fulmsch/ZI28/system/os/src/drivers/unio.org

#+TITLE: UNI/O EEPROM driver
#+PROPERTY: header-args :tangle yes

The start of a driver for the ROM on the expansion modules. Might not share an
interface with the other drivers.

#+BEGIN_SRC asm
SECTION rom_code
#code ROM
unio_fileDriver:
    DEFW unio_read
    DEFW 0 ;write

#define UNIO_STARTHEADER 0x55
#define UNIO_READ        0x03
#define UNIO_CRRD        0x06
#define UNIO_WRITE       0x6c
#define UNIO_WREN        0x96
#define UNIO_WRDI        0x91
#define UNIO_RDSR        0x05
#define UNIO_WRSR        0x6e
#define UNIO_ERAL        0x6d
#define UNIO_SETAL       0x67

unio_read:
;;
;; Input:
;; : ix - file entry addr
;; : (de) - buffer
;; : bc - count
;;
;; Output:
;; : de - count
;; : a - errno
#+END_SRC
