fulmsch/ZI28/system/os/src/math.org

#+TITLE: Math library
#+PROPERTY: header-args :tangle yes

Advanced math routines

Based on: <http://www.ticalc.org/pub/83/asm/source/routines/math32.inc>

* 32-bit registers
Define three variables to be used as temporary registers for 32-bit operations.

#+BEGIN_SRC asm
#data RAM
regA: defs 4
regB: defs 4
regC: defs 4

#code ROM
#+END_SRC

* Addition

#+BEGIN_SRC asm
add32:
;; Add two 32-bit numbers
;;
;; Input:
;; : (hl), (de) - 32-bit numbers
;;
;; Output:
;; : (hl) = (hl) + (de)
;;
;; Destroyed:
;; : none

    ;clear the carry flag
    or a

adc32:
;; Add two 32-bit numbers and the carry bit
;;
;; Input:
;; : (hl), (de) - 32-bit numbers
;;
;; Output:
;; : (hl) = (hl) + (de) + cf
;;
;; Destroyed:
;; : none

#local
    push af
    push bc
    push de
    push hl

    ld b, 4
loop:
    ld a, (de)
    adc a, (hl)
    ld (hl), a
    inc hl
    inc de
    djnz loop

    pop hl
    pop de
    pop bc
    pop af

    ret
#endlocal
#+END_SRC

* Subtraction

#+BEGIN_SRC asm
sub32:
;; Subtract two 32-bit numbers
;;
;; Input:
;; : (hl), (de) - 32-bit numbers
;;
;; Output:
;; : (de) = (de) - (hl)
;;
;; Destroyed:
;; : none

    ;clear the carry flag
    or a

sbc32:
;; Subtract two 32-bit numbers and the carry bit
;;
;; Input:
;; : (hl), (de) - 32-bit numbers
;;
;; Output:
;; : (de) = (de) - (hl) - cf
;;
;; Destroyed:
;; : none

#local
    push af
    push bc
    push de
    push hl

    ld b, 4
loop:
    ld a, (de)
    sbc a, (hl)
    ld (de), a
    inc de
    inc hl
    djnz loop

    pop hl
    pop de
    pop bc
    pop af

    ret
#endlocal
#+END_SRC

* Inc32

#+BEGIN_SRC asm
inc32:
;; Increment a 32-bit number by 1
;;
;; Input:
;; : (hl) - 32-bit number
;;
;; Output:
;; : (hl) = (hl) + 1
;;
;; Destroyed:
;; : none

#local
    push hl

    inc (hl)
    jr nz, exit
    inc hl
    
    inc (hl)
    jr nz, exit
    inc hl

    inc (hl)
    jr nz, exit
    inc hl

    inc (hl)

exit:
    pop hl
    ret
#endlocal
#+END_SRC

* Dec32

#+BEGIN_SRC asm
dec32:
;; Decrement a 32-bit number by 1
;;
;; Input:
;; : (hl) - 32-bit number
;;
;; Output:
;; : (hl) = (hl) - 1
;;
;; Destroyed:
;; : none

#local
    push hl

    dec (hl)
    jp p, exit
    inc hl

    dec (hl)
    jp p, exit
    inc hl

    dec (hl)
    jp p, exit
    inc hl

    dec (hl)

exit:
    pop hl
    ret
#endlocal
#+END_SRC

* Shifts
There are currently three shift instructions for each direction:
 - Shift one bit (multiplication by 2)
 - Shift 8 bits (multiplication by 256)
 - Shift 9 bits (multiplication by 512)

** Left shift

#+BEGIN_SRC asm
lshiftbyte32:
;; Shift a 32-bit number left by 1 byte
;;
;; Input:
;; : (hl) - 32-bit number
;;
;; Output:
;; : (hl) = (hl) << 8
;;
;; Destroyed:
;; : none

    push af
    push hl

    inc hl
    inc hl

    ld a, (hl)
    inc hl
    ld (hl), a
    dec hl
    dec hl

    ld a, (hl)
    inc hl
    ld (hl), a
    dec hl
    dec hl

    ld a, (hl)
    inc hl
    ld (hl), a
    dec hl
    ld (hl), 0

    pop hl
    pop af
    ret

lshift9_32:
;; Shift a 32-bit number left by 9 bits
;;
;; Input:
;; : (hl) - 32-bit number
;;
;; Output:
;; : (hl) = (hl) << 9
;;
;; Destroyed:
;; : none

    call lshiftbyte32

lshift32:
;; Shift a 32-bit number left by 1 bit
;;
;; Input:
;; : (hl) - 32-bit number
;;
;; Output:
;; : (hl) = (hl) << 1
;; : carry flag
;;
;; Destroyed:
;; : none

    push hl

    or a
    rl (hl)
    inc hl
    rl (hl)
    inc hl
    rl (hl)
    inc hl
    rl (hl)

    pop hl
    ret
#+END_SRC

** Right shift

#+BEGIN_SRC asm
rshiftbyte32:
;; Shift a 32-bit number right by 1 byte
;;
;; Input:
;; : (hl) - 32-bit number
;;
;; Output:
;; : (hl) = (hl) >> 8
;;
;; Destroyed:
;; : none

    push af
    push hl

    inc hl
    ld a, (hl)
    dec hl
    ld (hl), a
    inc hl

    inc hl
    ld a, (hl)
    dec hl
    ld (hl), a
    inc hl

    inc hl
    ld a, (hl)
    dec hl
    ld (hl), a
    inc hl

    ld (hl), 0

    pop hl
    pop af
    ret

rshift9_32:
;; Shift a 32-bit number right by 9 bits
;;
;; Input:
;; : (hl) - 32-bit number
;;
;; Output:
;; : (hl) = (hl) >> 9
;;
;; Destroyed:
;; : none

    call rshiftbyte32

rshift32:
;; Shift a 32-bit number right by 1 bit
;;
;; Input:
;; : (hl) - 32-bit number
;;
;; Output:
;; : (hl) = (hl) >> 1
;; : carry flag
;;
;; Destroyed:
;; : none

    or a
    inc hl
    inc hl
    inc hl

    rr (hl)
    dec hl
    rr (hl)
    dec hl
    rr (hl)
    dec hl
    rr (hl)
    ret
#+END_SRC

* Load

#+BEGIN_SRC asm
ld8:
;; Load an 8-bit number into a 32-bit pointer
;;
;; Input:
;; : a - 8-bit number
;; : hl - 32-bit pointer
;;
;; Output:
;; : (hl) = a
;;
;; Destroyed:
;; : none

    ;clear (hl)
    call clear32
    ld (hl), a
    ret

ld16:
;; Load a 16-bit number into a 32-bit pointer
;;
;; Input:
;; : de - 16-bit number
;; : hl - 32-bit pointer
;;
;; Output:
;; : (hl) = de
;;
;; Destroyed:
;; : none

    push hl

    ld (hl), e
    inc hl
    ld (hl), d
    inc hl
    ld (hl), 0
    inc hl
    ld (hl), 0

    pop hl
    ret

ld32:
;; Copy a 32-bit number from (hl) to (de)
;;
;; Input:
;; : (hl) - 32-bit number
;; : de - 32-bit pointer
;;
;; Destroyed:
;; : none

    push bc
    push de
    push hl

    ld bc, 4
    ldir

    pop hl
    pop de
    pop bc

    ret
#+END_SRC

* Compare

#+BEGIN_SRC asm
cp32:
;; Compares two 32-bit numbers
;;
;; Input:
;; : (hl), (de) - 32-bit numbers
;;
;; Output:
;; : c  - (hl) >  (de)
;; : nc - (hl) <= (de)
;; : z  - (hl) == (de)
;; : nz - (hl) != (de)
;;
;; Destroyed:
;; : a, b, de, hl

#local
;move the pointers to the msb
    ld b, 3
startLoop:
    inc hl
    inc de
    djnz startLoop

    ld b, 4
loop:
    ld a, (de)
    cp (hl)
    ret nz
    dec hl
    dec de
    djnz loop
    ret
#endlocal
#+END_SRC

* Clear

#+BEGIN_SRC asm
clear32:
;; Sets a 32-bit number to 0
;;
;; Input:
;; : (hl) - 32-bit number
;;
;; Output:
;; : (hl) = 0
;;
;; Destroyed:
;; : none

#local
    push hl
    push bc
    ld b, 4
loop:
    ld (hl), 0
    inc hl
    djnz loop

    pop bc
    pop hl
    ret
#endlocal
#+END_SRC
