fulmsch/ZI28/system/os/src/block.org

#+TITLE: Block device interface
#+PROPERTY: header-args :tangle yes

#+BEGIN_SRC asm

#data RAM
block_buffer:        defs 512
block_curBlock:      defs   4
block_endBlock:      defs   4
block_remCount:      defs   2
block_totalCount:    defs   2
block_relOffs:       defs   2
block_readCallback:  defs   2
block_writeCallback: defs   2
block_memPtr:        defs   2

#code ROM
;TODO give this a better name
block_calcCopyPointers:
;; Calculate the amount of bytes to be copied in a partial block operation
;;
;; Output:
;; bc - count
;; de - memory pointer
;; hl - buffer pointer

#local
    ld hl, 512
    ld de, (block_relOffs)
    or a
    sbc hl, de
    push hl ;bytes to end of block
    ;check if block_remCount < hl
    ld bc, (block_remCount)
    sbc hl, bc
    pop hl
    jr nc, remCount ;only read remCount bytes
    ld b, h
    ld c, l

remCount:
    ld hl, block_buffer
    add hl, de ;buffer + reloffs

    ld de, (block_memPtr)

    ret
#endlocal

block_nextBlock:
;; Advance to next block
;;
;; Input:
;; : bc - count

    ld hl, (block_totalCount)
    add hl, bc
    ld (block_totalCount), hl

    ld hl, (block_memPtr)
    add hl, bc
    ld (block_memPtr), hl

    ld hl, (block_remCount)
    or a
    sbc hl, bc
    ld (block_remCount), hl

    ld hl, block_curBlock
    jp inc32

#+END_SRC

* Init
#+BEGIN_SRC asm
#code ROM

block_init:
;; Calculate the current and final block, and the relative offset
;;
;; Output:
;; : carry - start with a partial block
;; : no carry - start with a full block

#local
    ;get address of file offset
    ld de, fileTableOffset
    push ix
    pop hl
    add hl, de
    push hl
    ;(hl) = file offset

    ;calculate current block
    ld de, block_curBlock
    call ld32

    ld hl, block_curBlock
    call rshift9_32

    ;calculate final block
    pop hl ;file offset
    push hl ;file offset
    ld de, block_endBlock
    call ld32

    ld de, (block_remCount)
    dec de
    ld hl, regA
    call ld16

    ld hl, block_endBlock
    ld de, regA
    call add32

    call rshift9_32

    ;calculate offset relative to block start
    pop de ;file offset
    ld a, (de)
    ld l, a
    inc de
    ld a, (de)
    and 1
    ld h, a
    ld (block_relOffs), hl

    xor a
    cp h
    jr nz, partial
    cp l
    ret z

partial:
    scf
    ret
#endlocal

#+END_SRC

* Read
#+BEGIN_SRC asm
#code ROM

block_read:
;; Translate random access into block based read.
;;
;; Input:
;; : ix - file entry addr
;; : (de) - buffer
;; : bc - count
;; : (hl) - block device driver callback structure
;;
;; Output:
;; : de - count
;; : a - errno

#local
    ld (block_memPtr), de
    ld e, (hl)
    inc hl
    ld d, (hl)
    ld (block_readCallback), de
    ld (block_remCount), bc
    ld de, 0
    ld (block_totalCount), de

    call block_init
    call c, partialRead

fullReadLoop:
    cp 0 ;errno of prev command
    ret nz

    ld hl, block_endBlock
    ld de, block_curBlock
    call cp32
    jr nc, lastBlock

    call fullRead
    jr fullReadLoop

lastBlock:
    ld de, end
    push de ;return address

    ld hl, (block_remCount)
    xor a
    ld d, a
    ld e, a
    sbc hl, de
    ret z ;jp to end
    ld de, 512
    sbc hl, de
    jr nz, partialRead

    jr fullRead

end:
    cp 0
    ret nz

    ld de, (block_totalCount)

    ;a is already 0
    ret

fullRead:
;read an entire block from disk
    ld de, fullReadReturn
    push de ;return address
    ld de, (block_memPtr)
    ld bc, block_curBlock
    ld hl, (block_readCallback)
    jp (hl)

fullReadReturn:
    cp 0
    ret nz

    ld bc, 512
    call block_nextBlock

    xor a
    ret

partialRead:
;read part of a block from disk, utilizing the block buffer

    ;read the entire block into the buffer
    ld de, partialReadReturn
    push de ;return address
    ld de, block_buffer
    ld bc, block_curBlock
    ld hl, (block_readCallback)
    jp (hl)

partialReadReturn:
    cp 0
    ret nz

    ;copy data to memory
    call block_calcCopyPointers
    push bc ;number of bytes to be copied
    ldir

    pop bc

    call block_nextBlock

    ld hl, 0
    ld (block_relOffs), hl

    xor a
    ret

error:
    ld de, (block_totalCount)
    ret
#endlocal

#+END_SRC

* Write
#+BEGIN_SRC asm
#code ROM

block_write:
;; Translate random access into block based write.
;;
;; Input:
;; : ix - file entry addr
;; : (de) - buffer
;; : bc - count
;; : (hl) - block device driver callback structure
;;
;; : de - count
;; : a - errno

#local
    ld (block_memPtr), de
    ld e, (hl)
    inc hl
    ld d, (hl)
    inc hl
    ld (block_readCallback), de
    ld e, (hl)
    inc hl
    ld d, (hl)
    ld (block_writeCallback), de
    ld (block_remCount), bc
    ld de, 0
    ld (block_totalCount), de

    call block_init
    call c, partialWrite

    ;while curBlock < endBlock
    ;while cp32(hl=curBlock, de=endBlock) == c
fullWriteLoop:
    cp 0 ;errno of prev command
    ret nz

    ld hl, block_endBlock
    ld de, block_curBlock
    call cp32
    jr nc, lastBlock

    call fullWrite
    jr fullWriteLoop

lastBlock:
    ld de, end
    push de ;return address

    ld hl, (block_remCount)
    xor a
    ld d, a
    ld e, a
    sbc hl, de
    ret z ;jp to end
    ld de, 512
    sbc hl, de
    jr nz, partialWrite

    jr fullWrite

end:
    cp 0
    ret nz

    ld de, (block_totalCount)

    ;a is already 0
    ret

fullWrite:
; write an entire block to disk
    ld de, fullWriteReturn
    push de ;return address
    ld de, (block_memPtr)
    ld bc, block_curBlock
    ld hl, (block_writeCallback)
    jp (hl)

fullWriteReturn:
    cp 0
    ret nz

    ld bc, 512
    call block_nextBlock

    xor a
    ret

partialWrite:
; write part of a block to disk, utilizing the block buffer

    ;read the entire block into the buffer
    ld de, partialWriteReadReturn
    push de ;return address
    ld de, block_buffer
    ld bc, block_curBlock
    ld hl, (block_readCallback)
    jp (hl)

partialWriteReadReturn:
    cp 0
    ret nz

    ;copy data to be written into buffer
    call block_calcCopyPointers
    push bc ;number of bytes to be copied

    ex de, hl

    ldir

    ld de, partialWriteReturn
    push de ;return address
    ld de, block_buffer
    ld bc, block_curBlock
    ld hl, (block_writeCallback)
    jp (hl)

partialWriteReturn:
    pop bc ;number of changed bytes written
    cp 0
    ret nz

    call block_nextBlock

    ld hl, 0
    ld (block_relOffs), hl

    xor a
    ret

error:
    ld de, (block_totalCount)
    ret
#endlocal

#+END_SRC
