fulmsch/ZI28/system/os/src/drivers/vt100.org

#+TITLE: VT100 terminal driver
#+PROPERTY: header-args :tangle yes

This is a work in progress and currently not included in the OS.

I think it is intended to emulate a VT100 terminal on the VGA display, but some
of it seems to be copied from the FT240 driver and still contains some of those descriptions.

#+BEGIN_SRC asm
#define vt100_fileTablePosx dev_fileTableData + 5 ; TODO devfs_open copies the custom data of the devfs entry. This needs to be documented / defined somewhere
#define vt100_fileTablePosy vt100_fileTablePosx + 1

#define vt100_devfsScreenBuffer devfs_data

#code ROM
vt100_deviceDriver:
    DEFW vt100_init
    DEFW 0 ;vt100_read
    DEFW vt100_write
#+END_SRC

* Init
The screen buffer contains two bytes per character. First byte: ascii character;
Second byte: foreground and background color

#+BEGIN_SRC asm
#code ROM
vt100_init:
;; Input:
;; : (de) - custom data start (screenBuffer)
    push de
    ld hl, 1536 ; 32 x 24 characters, 2 bytes / character
    call kalloc
    pop de
    cp 0
    ret nz

    ex de, hl
    ; store de (address of screenBuffer) in (hl)
    ld (hl), e
    inc hl
    ld (hl), d

    push de ;screen buffer
    ;clear screen buffer
    ld h, d
    ld l, e
    inc de
    ld bc, 1535
    ld (hl), 0x00
    ldir
    pop de ;screen buffer

;    ld h, d
;    ld l, e
;    ld (hl), 'H'
;    inc hl
;    inc hl
;    ld (hl), 'e'
;    inc hl
;    inc hl
;    ld (hl), 'l'
;    inc hl
;    inc hl
;    ld (hl), 'l'
;    inc hl
;    inc hl
;    ld (hl), 'o'
;    inc hl
;    inc hl
;    ld (hl), ' '
;    inc hl
;    inc hl
;    ld (hl), 'W'
;    inc hl
;    inc hl
;    ld (hl), 'o'
;    inc hl
;    inc hl
;    ld (hl), 'r'
;    inc hl
;    inc hl
;    ld (hl), 'l'
;    inc hl
;    inc hl
;    ld (hl), 'd'
;    inc hl
;    inc hl
;    ld (hl), '!'
;    inc hl
;    inc hl

    call vt100_drawScreen

    ret
#+END_SRC

#+BEGIN_SRC asm
; Inputs:
; : de - screen buffer
vt100_drawScreen:
#local
    ;de = screen buffer

    ; Go to screen location 0,0
    xor a
    ld (xOffs), a
    ld (yOffs), a
    out (0x93), a

    ld hl, 1536
    add hl, de
    ld (endPointer), hl

loop:
    ld a, (de)

    push de

    ld hl, fontTable

    ; Each font character is 8 bytes long, so left shift the offset by 3
    ld b, 0
    add a, a
    ; Discard MSB by not shifting it into b
    add a, a
    rl b
    add a, a
    rl b
    ld c, a

    adc hl, bc
    ;(hl): font table entry
    ld b, 8 ;vertical counter

; draw a complete character
vLoop:
    ld a, (yOffs)
    add a, 8
    sub a, b
    out (0x92), a ;yreg
    ld a, (xOffs)
    out (0x91), a ;xreg

    ld d, (hl) ; font row
    inc hl

    ld c, 4 ; each char is 8 pixels wide = 4 bytes
hloop:
    ld a, 0 ;set both pixels to black
    rlc d
    jr nc, blank0
    or 0x0f
blank0:
    rlc d
    jr nc, blank1
    or 0xf0
blank1:
    out (0x97), a ;data inc

    dec c
    jr nz, hloop

    djnz vLoop

    pop de
    inc de
    inc de
    ld hl, (endPointer)
    or a
    sbc hl, de
    ret z

    ld hl, xOffs
    ld a, 4
    add a, (hl)
    ld (hl), a
    cp 128
    jr nz, loop

    xor a
    ld (hl), a

    ld hl, yOffs
    ld a, 8
    add a, (hl)
    ld(hl), a
    jr loop
    ret

#data RAM
xOffs: defb 0
yOffs: defb 0
endPointer: defw 0
#code ROM
#endlocal
#+END_SRC

* Write
#+BEGIN_SRC asm
#code ROM
vt100_write:
;; Input:
;; : ix - file entry addr
;; : (de) - buffer
;; : bc - count
;;
;; Output:
;; : de - count
;; : a - errno
; Errors: 0=no error

#local

    push de
    ld e, (ix + dev_fileTableDirEntry)
    ld d, (ix + dev_fileTableDirEntry + 1)
    ld hl, vt100_devfsScreenBuffer
    add hl, de
    ; (hl) = &screenBuffer
    ld e, (hl)
    inc hl
    ld d, (hl)
    ; (de) = screenBuffer
    ex de, hl
    ld (screenBuffer), hl
    pop de

    ;calculate loop value in bc
    ld a, c
    dec bc
    inc b
    ld c, b
    ld b, a

    ld hl, 0

poll:
    ld a, (de)
    push bc ; count down
    push de ; string index
    push hl ; count up
    call handleChar
    pop hl
    pop de
    pop bc
    inc de
    inc hl
    djnz poll
    dec c
    jr nz, poll

    ex de, hl
    ; push de
    ; ld hl, (screenBuffer)
    ; ex de, hl
    ; call vt100_drawScreen
    ; pop de
    ret

handleChar:
    push af
    ld h, (ix + vt100_fileTablePosy)
    ld a, h
    add a, a
    add a, a
    add a, a
    ld (yOffs), a
    ld l, 0
    srl h
    rr l
    srl h
    rr l

    ld c, (ix + vt100_fileTablePosx)
    ld a, c
    add a, a
    add a, a
    ld (xOffs), a
    sla c
    ld b, 0
    pop af

    add hl, bc
    ;hl = offset
    ex de, hl

    ld hl, (screenBuffer)
    add hl, de

    cp 0x0a ;'\n'
    jr z, newline
    cp 0x08 ; backspace
    jr z, backspace

    ld (hl), a

    ; TODO optimize
    inc (ix + vt100_fileTablePosx)
    ld a, (ix + vt100_fileTablePosx)
    cp 32
    jr c, drawChar
    ; Fall through to newline if new cursor position is past end of line

newline:
    ld (ix + vt100_fileTablePosx), 0

    ld a, (ix + vt100_fileTablePosy)
    inc a
    cp 24
    jr nc, scroll
    ld (ix + vt100_fileTablePosy), a
    jr drawChar

scroll:
    ld hl, (screenBuffer)
    ld d, h
    ld e, l
    ld bc, 32 * 2
    add hl, bc ; hl = screenBuffer + 32 chars, de = screenBuffer
    ld bc, 32 * 2 * 23
    ldir

    ld h, d
    ld l, e
    ld (hl), 0
    inc de
    ld bc, 32 * 2 - 1
    ldir

    ld (ix + vt100_fileTablePosy), 23

    ld hl, (screenBuffer)
    ex de, hl
    call vt100_drawScreen
    ret

backspace:
    ld a, (ix + vt100_fileTablePosx)
    dec a
    jp p, positive
    xor a
positive:
    ld (ix + vt100_fileTablePosx), a
    ret

#data RAM
screenBuffer:
    defs 2
#code ROM

drawChar:
    ld a, (hl)

    ld hl, fontTable

    ; Each font character is 8 bytes long, so left shift the offset by 3
    ld b, 0
    add a, a
    ; Discard MSB by not shifting it into b
    add a, a
    rl b
    add a, a
    rl b
    ld c, a

    adc hl, bc
    ;(hl): font table entry
    ld b, 8 ;vertical counter

; draw a complete character
vLoop:
    ld a, (yOffs)
    add a, 8
    sub a, b
    out (0x92), a ;yreg
    ld a, (xOffs)
    out (0x91), a ;xreg

    ld d, (hl) ; font row
    inc hl

    ld c, 4 ; each char is 8 pixels wide = 4 bytes
hloop:
    ld a, 0 ;set both pixels to black
    rlc d
    jr nc, blank0
    or 0x0f
blank0:
    rlc d
    jr nc, blank1
    or 0xf0
blank1:
    out (0x97), a ;data inc

    dec c
    jr nz, hloop

    djnz vLoop
    ret
#data RAM
xOffs:
    defs 1
yOffs:
    defs 1
#code ROM
#endlocal
#+END_SRC
