fulmsch/ZI28/hardware/modules/vga/vga.pdf

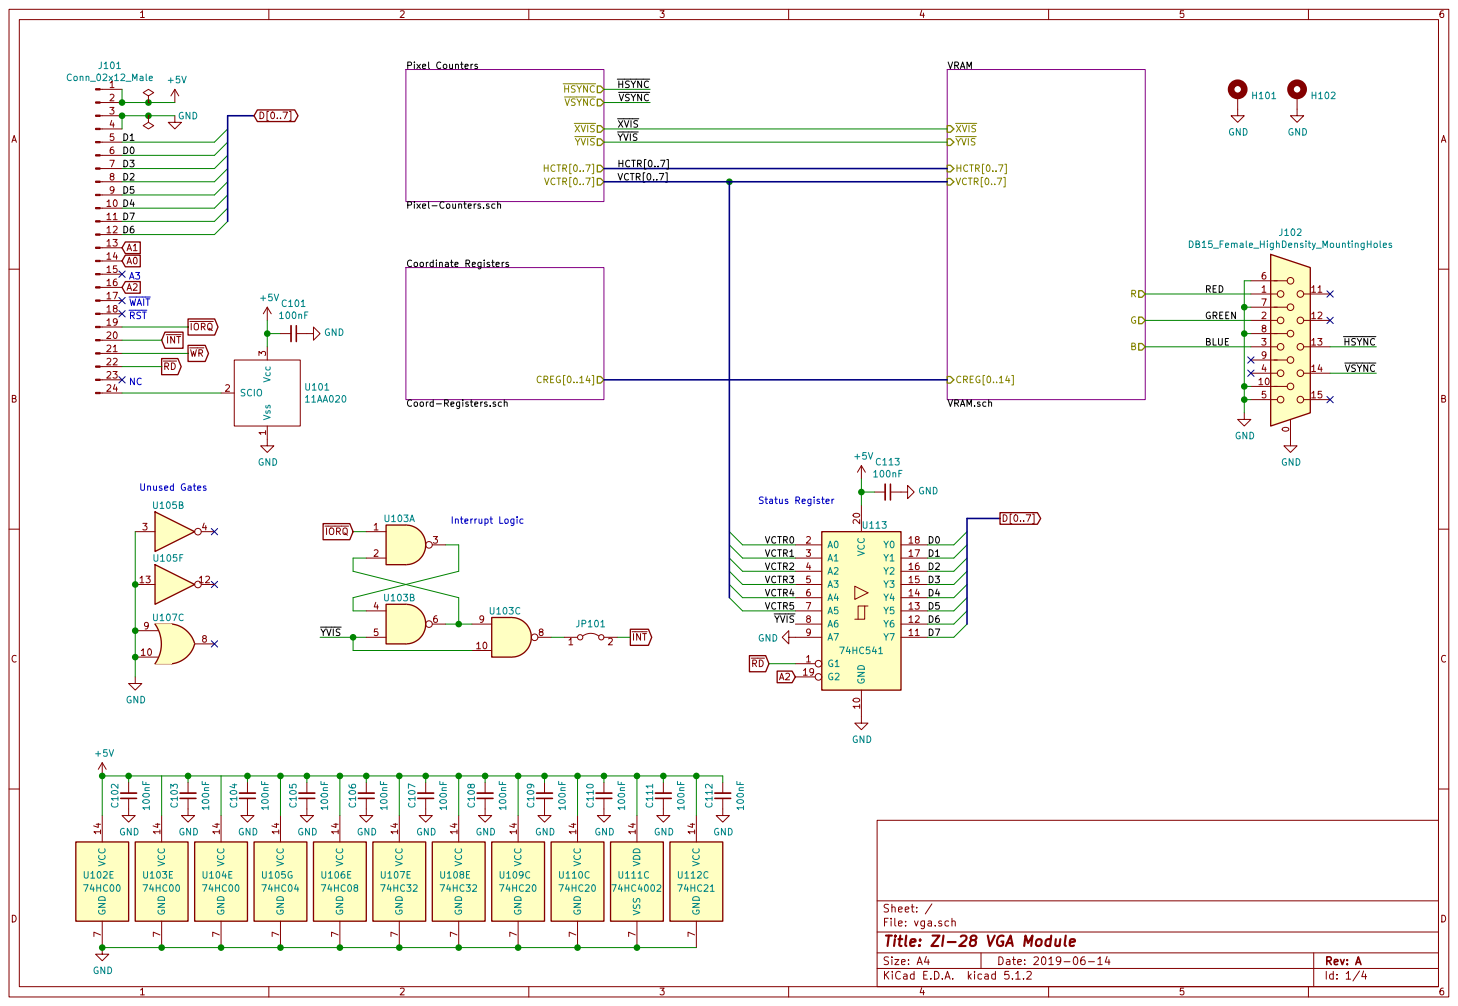
[picture p1: page 1]

VRAM.sch YVIS HCTR[0..7]

File: vga.sch Sheet: /
Id: 1/4 Title: ZI-28 VGA Module

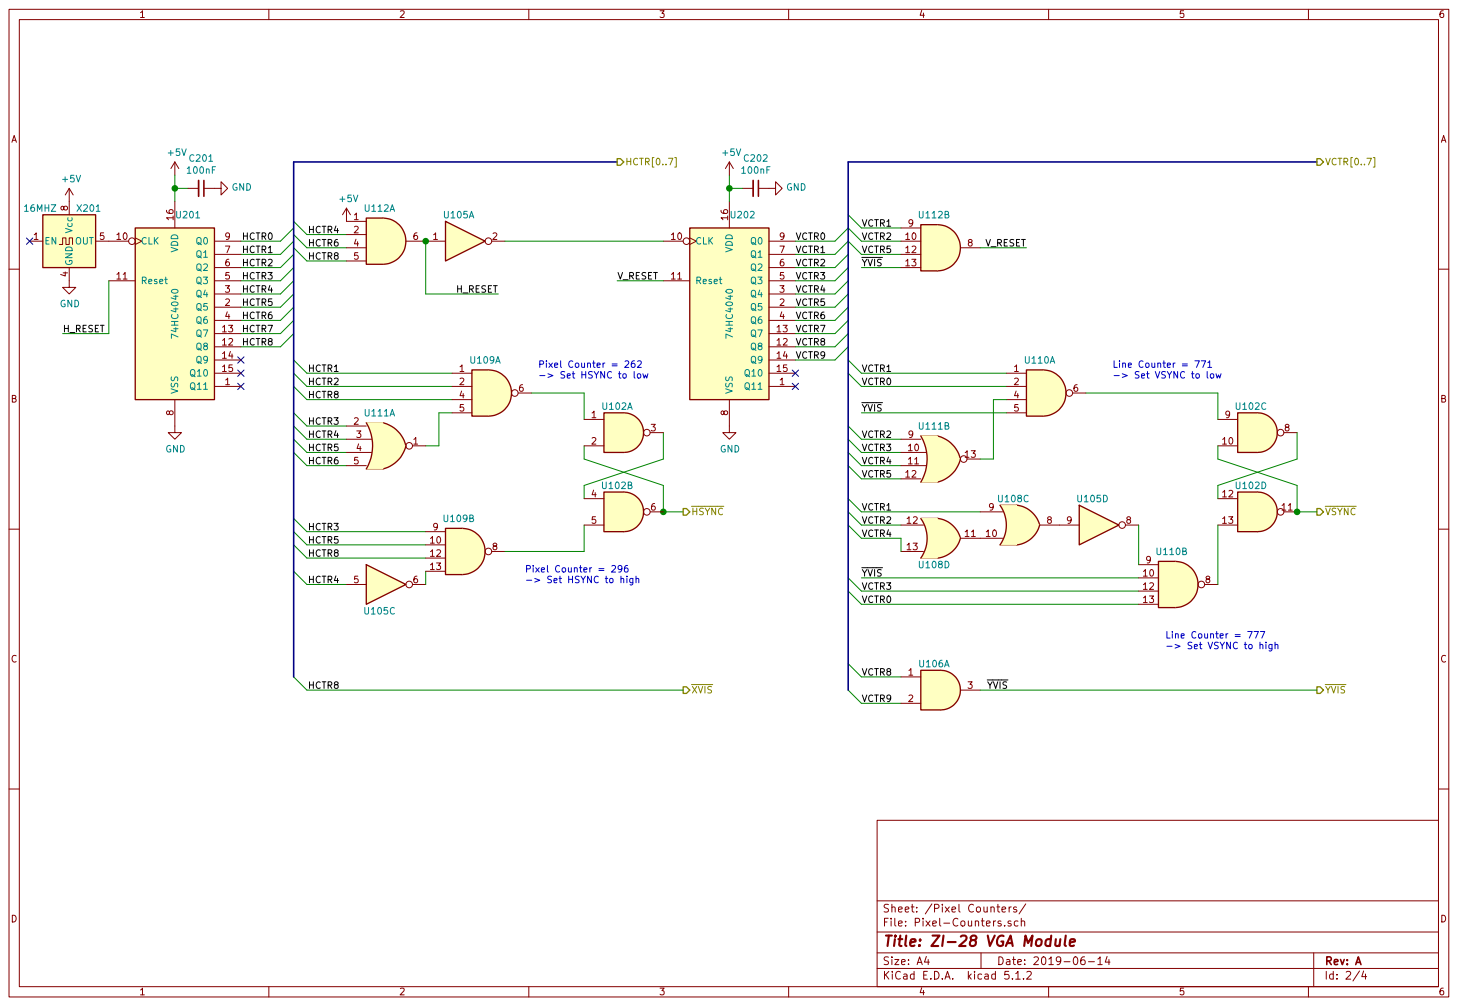
[picture p2: page 2]

-> Set HSYNC to high Pixel Counter = 262
-> Set HSYNC to low

Line Counter = 771
-> Set VSYNC to low

File: Pixel-Counters.sch Sheet: /Pixel Counters/
Id: 2/4 Title: ZI-28 VGA Module

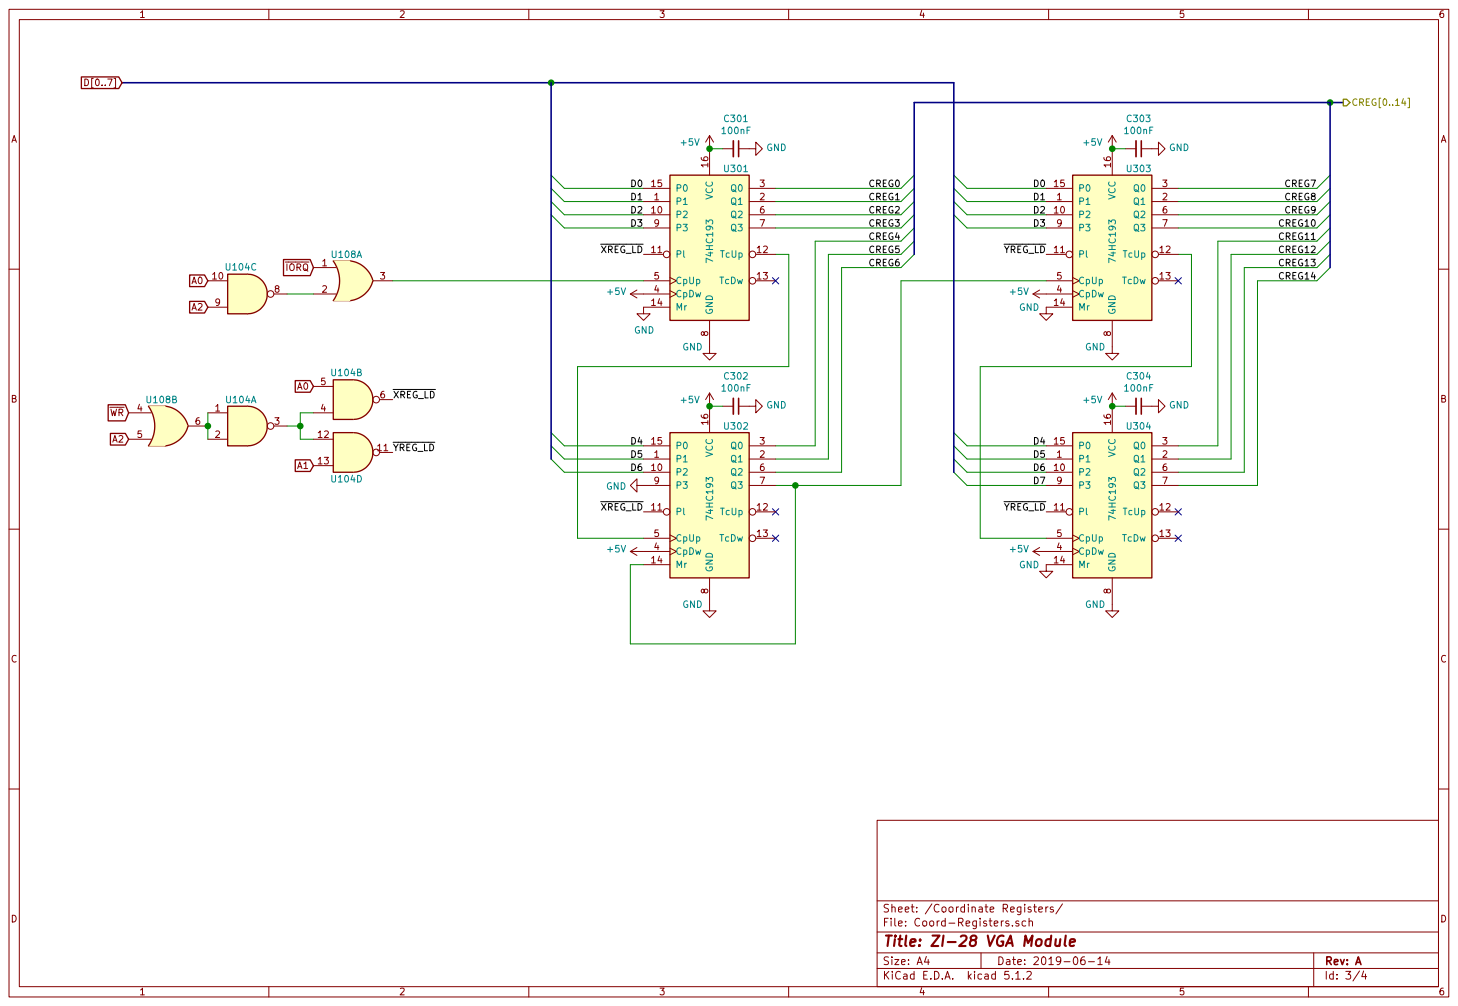
[picture p3: page 3]

8 P3 9 U301 74HC193 P1 1 P2 10 Pl 11 TcUp 12 TcDw 13 Mr 14 P0 15 VCC 16 Q1 2 Q0 3 CpDw 4 CpUp 5 Q2 6 Q3 7 GND

8 P3 9 U302 74HC193 P1 1 P2 10 Pl 11 TcUp 12 TcDw 13 Mr 14 P0 15 VCC 16 Q1 2 Q0 3 CpDw 4 CpUp 5 Q2 6 Q3 7 GND

8 P3 9 U303 74HC193 P1 1 P2 10 Pl 11 TcUp 12 TcDw 13 Mr 14 P0 15 VCC 16 Q1 2 Q0 3 CpDw 4 CpUp 5 Q2 6 Q3 7 GND

Sheet: /Coordinate Registers/
File: Coord-Registers.sch
Id: 3/4 Title: ZI-28 VGA Module

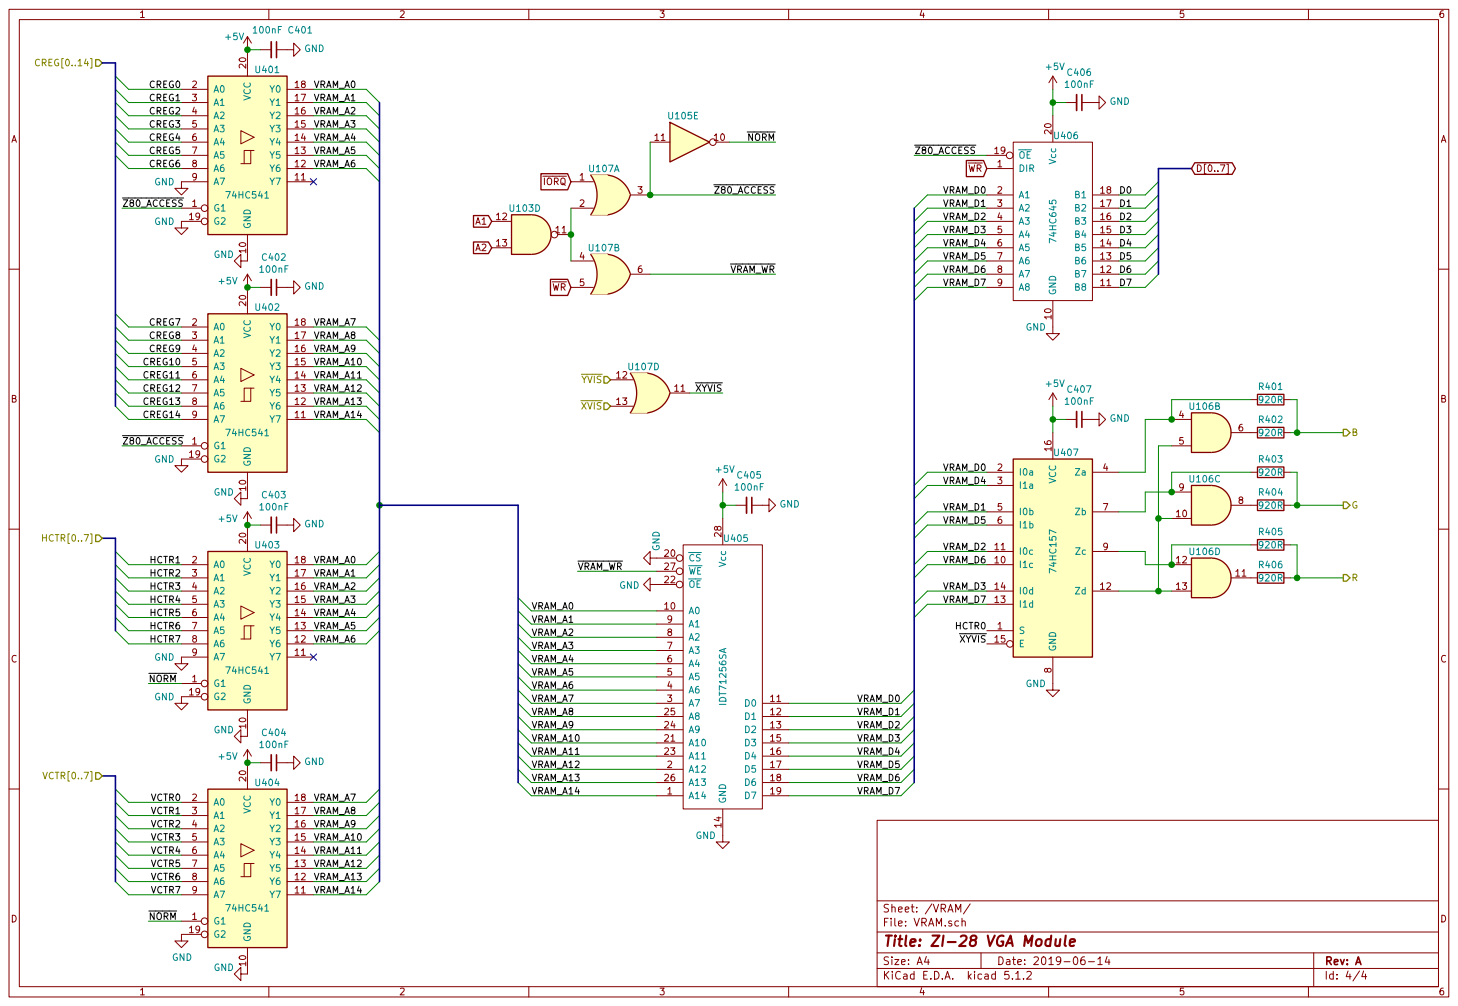
[picture p4: page 4]

File: VRAM.sch Sheet: /VRAM/ GND

Id: 4/4 Title: ZI-28 VGA Module
