fulmsch/ZI28/hardware/modules/vga-v2/vga-v2.kicad_pcb

## KiCad design hardware/modules/vga-v2/vga-v2.kicad_pcb (2019-12-12)

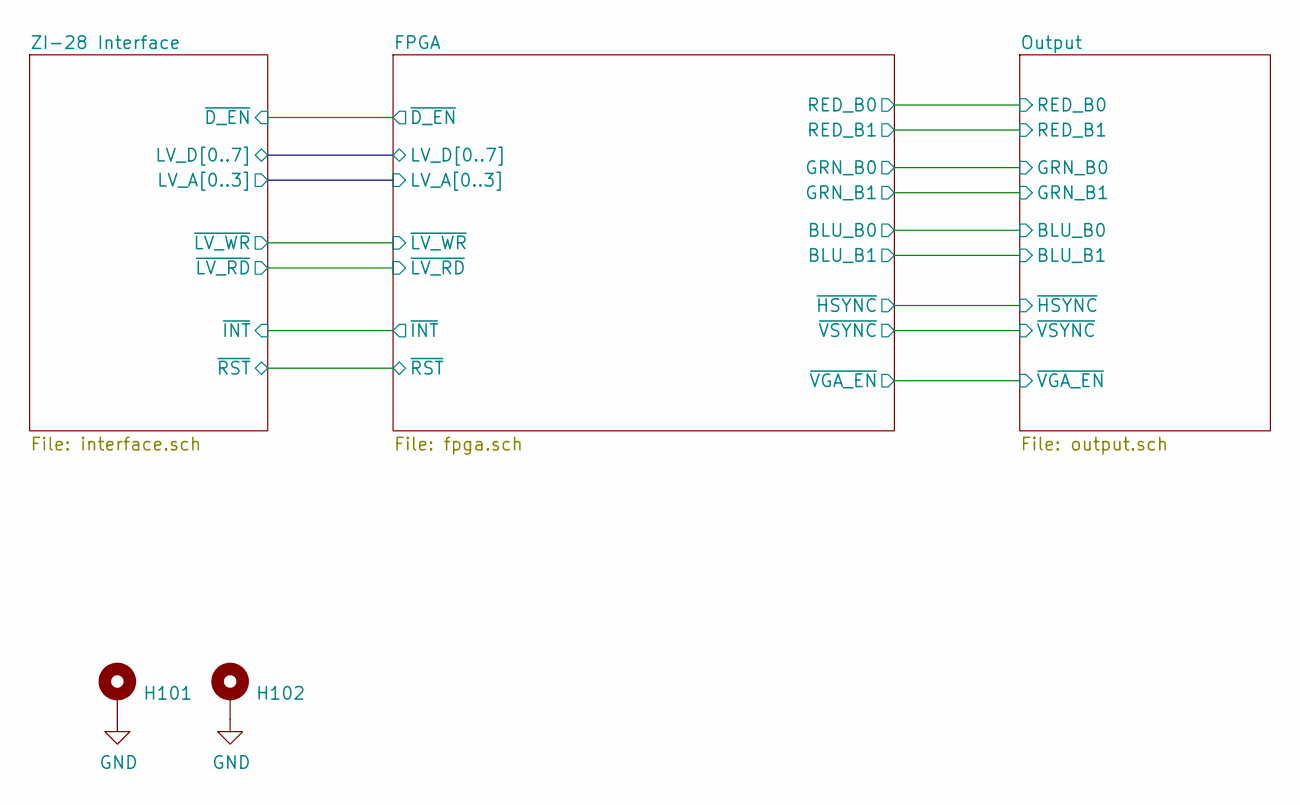
[picture p5: schematic vga-v2.sch]

Parts:
H101, H102: MountingHole_Pad; MountingHole_3.2mm_M3_Pad

Connections:
GND: H101.1, H102.1; also elsewhere on the board

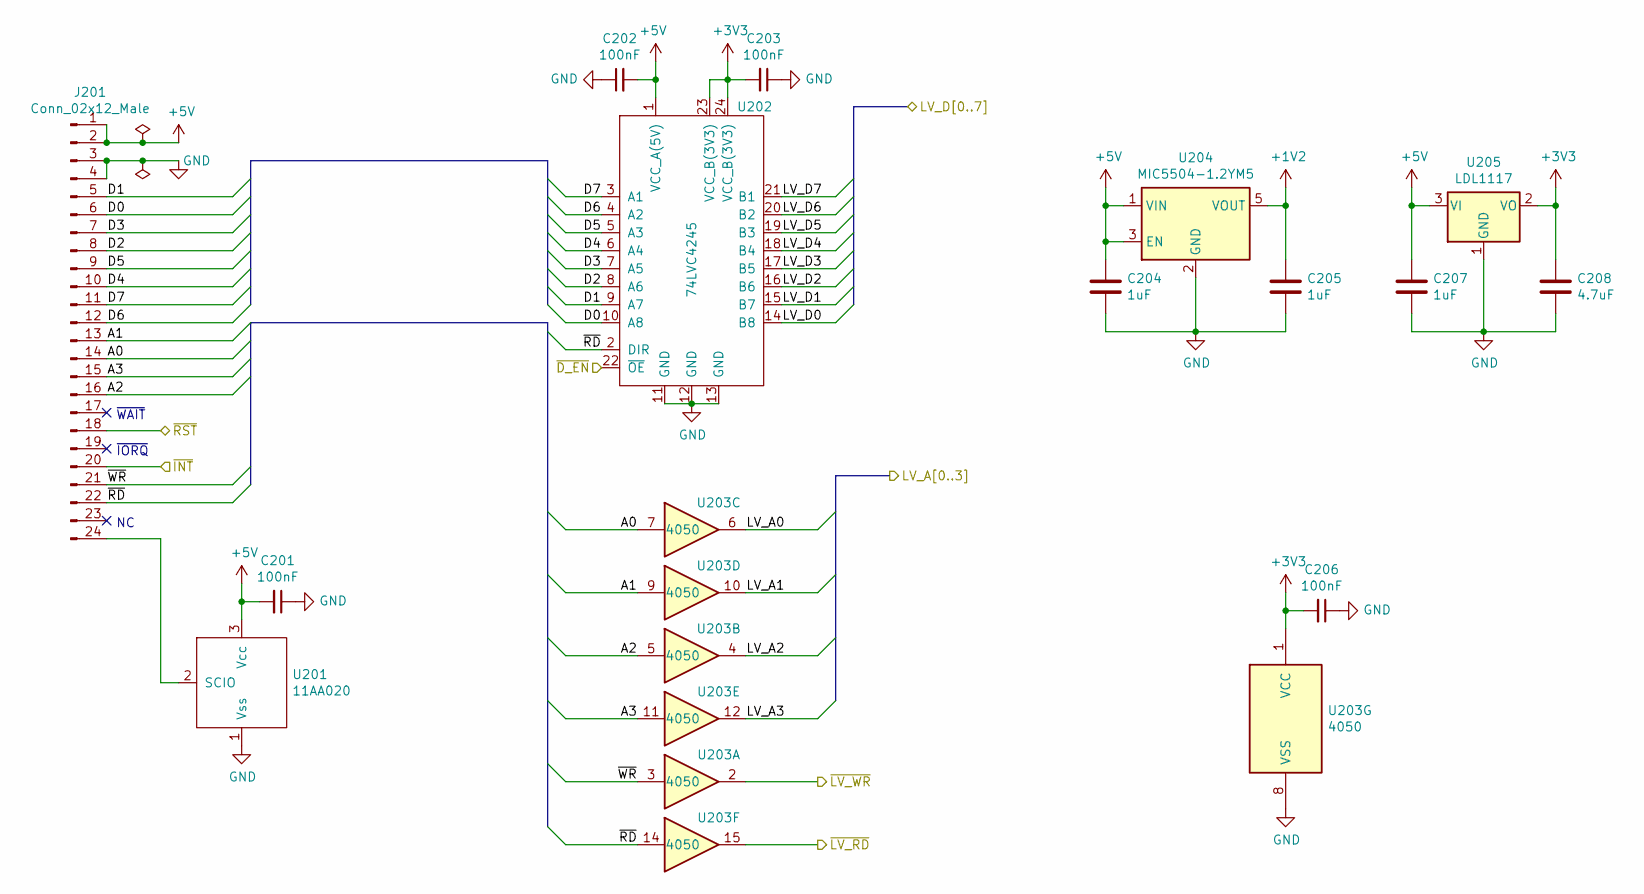
[picture p6: schematic interface.sch]

Parts:
C201, C202, C203, C206: 100nF; C_0805_2012Metric_Pad1.15x1.40mm_HandSolder
C204, C205, C207: 1uF; C_0805_2012Metric_Pad1.15x1.40mm_HandSolder
C208: 4.7uF; C_0805_2012Metric_Pad1.15x1.40mm_HandSolder
J201: Conn_02x12_Male; PinHeader_2x12_P2.54mm_Horizontal
U201: 11AA020; TO-92
U202: 74LVC4245; SOIC-24W_7.5x15.4mm_P1.27mm
U203: 4050; SOIC-16W_7.5x10.3mm_P1.27mm
U204: MIC5504-1.2YM5; SOT-23-5
U205: LDL1117; SOT-223-3_TabPin2

Connections:
+1V2: C205.1, U204.5 (VOUT); also elsewhere on the board
+3V3: C203.2, C206.2, C208.1, U202.23 (VCC_B(3V3)), U202.24 (VCC_B(3V3)), U203.1 (VCC), U205.2 (VO); also elsewhere on the board
+5V: C201.2, C202.2, C204.1, C207.1, J201.1, J201.2, U201.3 (Vcc), U202.1 (VCC_A(5V)), U204.1 (VIN), U204.3 (EN), U205.3 (VI)
/FPGA/LV_A0: U203.6; also elsewhere on the board
/FPGA/LV_A1: U203.10; also elsewhere on the board
/FPGA/LV_A2: U203.4; also elsewhere on the board
/FPGA/LV_A3: U203.12; also elsewhere on the board
/FPGA/LV_D0: U202.14 (B8); also elsewhere on the board
/FPGA/LV_D1: U202.15 (B7); also elsewhere on the board
/FPGA/LV_D2: U202.16 (B6); also elsewhere on the board
/FPGA/LV_D3: U202.17 (B5); also elsewhere on the board
/FPGA/LV_D4: U202.18 (B4); also elsewhere on the board
/FPGA/LV_D5: U202.19 (B3); also elsewhere on the board
/FPGA/LV_D6: U202.20 (B2); also elsewhere on the board
/FPGA/LV_D7: U202.21 (B1); also elsewhere on the board
/FPGA/~D_EN: U202.22 (~OE); also elsewhere on the board
/FPGA/~INT: J201.20; also elsewhere on the board
/FPGA/~LV_RD: U203.15; also elsewhere on the board
/FPGA/~LV_WR: U203.2; also elsewhere on the board
/FPGA/~RST: J201.18; also elsewhere on the board
/ZI-28 Interface/A0: J201.14, U203.7
/ZI-28 Interface/A1: J201.13, U203.9
/ZI-28 Interface/A2: J201.16, U203.5
/ZI-28 Interface/A3: J201.15, U203.11
/ZI-28 Interface/D0: J201.6, U202.10 (A8)
/ZI-28 Interface/D1: J201.5, U202.9 (A7)
/ZI-28 Interface/D2: J201.8, U202.8 (A6)
/ZI-28 Interface/D3: J201.7, U202.7 (A5)
/ZI-28 Interface/D4: J201.10, U202.6 (A4)
/ZI-28 Interface/D5: J201.9, U202.5 (A3)
/ZI-28 Interface/D6: J201.12, U202.4 (A2)
/ZI-28 Interface/D7: J201.11, U202.3 (A1)
/ZI-28 Interface/~RD: J201.22, U202.2 (DIR), U203.14
/ZI-28 Interface/~WR: J201.21, U203.3
GND: C201.1, C202.1, C203.1, C204.2, C205.2, C206.1, C207.2, C208.2, J201.3, J201.4, U201.1 (Vss), U202.11 (GND), U202.12 (GND), U202.13 (GND), U203.8 (VSS), U204.2 (GND), U205.1 (GND); also elsewhere on the board
unnamed: J201.24, U201.2 (SCIO)

Notes on the sheet:
~WAIT
~IORQ

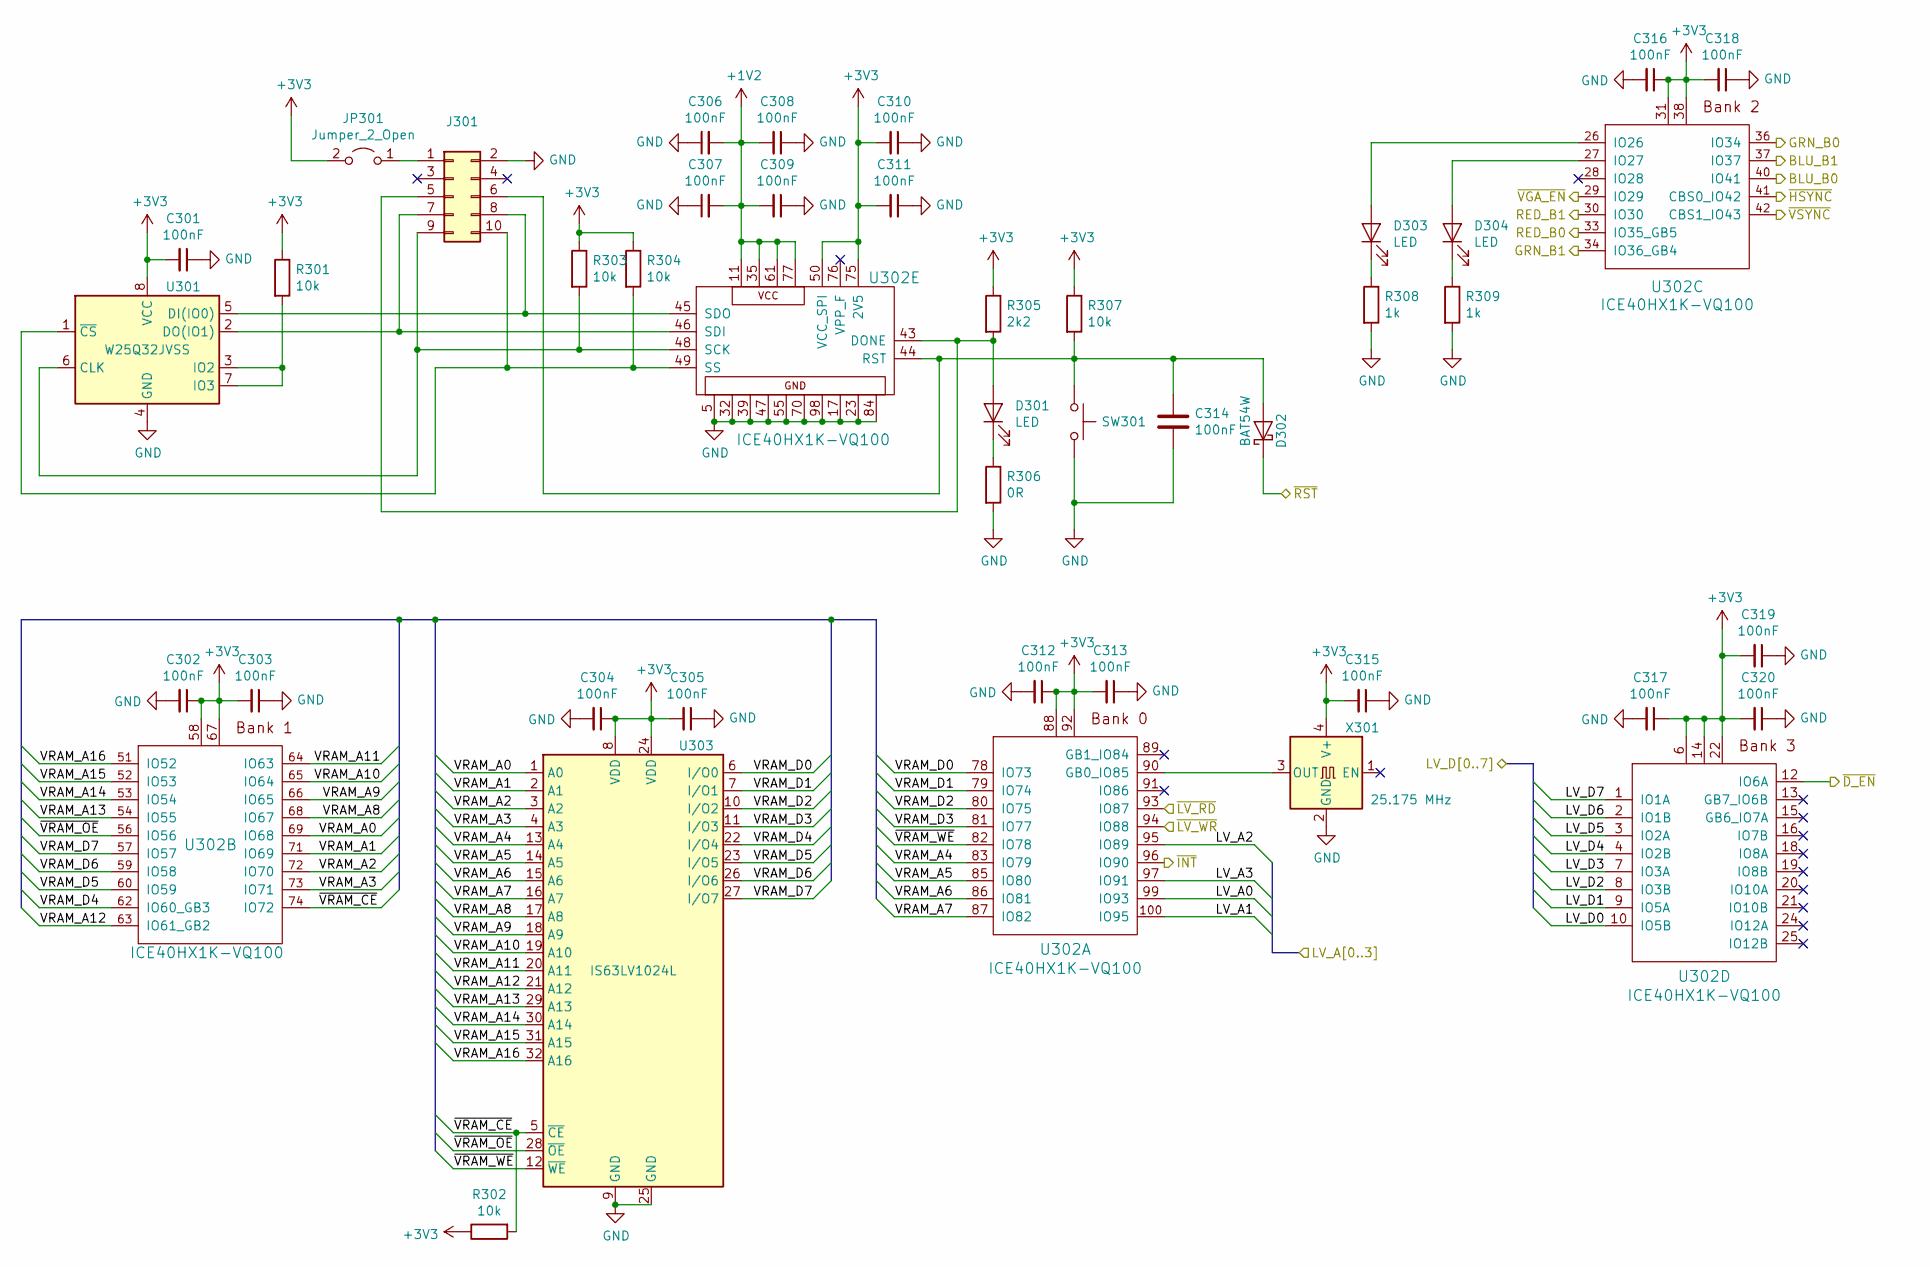
[picture p7: schematic fpga.sch]

Parts:
C301, C302, C303, C304, C305, C306, C307, C308, C309, C310, C311, C312, C313, C314, C315, C316, C317, C318, C319, C320: 100nF; C_0805_2012Metric_Pad1.15x1.40mm_HandSolder
D301, D303, D304: LED; LED_D3.0mm
D302: BAT54W; D_SOD-123
J301: Conn_02x05_Odd_Even; IDC-Header_2x05_P2.54mm_Vertical
JP301: Jumper_2_Open; PinHeader_1x02_P2.54mm_Vertical
R301, R302, R303, R304, R307: 10k; R_0805_2012Metric_Pad1.15x1.40mm_HandSolder
R305: 2k2; R_0805_2012Metric_Pad1.15x1.40mm_HandSolder
R306: 0R; R_0805_2012Metric_Pad1.15x1.40mm_HandSolder
R308, R309: 1k; R_0805_2012Metric_Pad1.15x1.40mm_HandSolder
SW301: SW_Push; SW_PUSH_6mm_H5mm
U301: W25Q32JVSS; DIP-8_W7.62mm_Socket
U302: ICE40HX1K-VQ100; VQFP-100_14x14mm_P0.5mm
U303: IS63LV1024L; TSOP-II-32_21.0x10.2mm_P1.27mm
X301: 25.175 MHz; Oscillator_SMD_Abracon_ASV-4Pin_7.0x5.1mm_HandSoldering

Connections:
+1V2: C306.2, C307.2, C308.2, C309.2, U302.11, U302.35, U302.61, U302.77; also elsewhere on the board
+3V3: C301.2, C302.1, C303.2, C304.1, C305.2, C310.2, C311.2, C312.1, C313.2, C315.2, C316.1, C317.1, C318.2, C319.2, C320.2, JP301.2 (B), R301.1, R302.1, R303.1, R304.1, R305.1, R307.1, U301.8 (VCC), U302.6, U302.14, U302.22, U302.31, U302.38, U302.50 (VCC_SPI), U302.58, U302.67, U302.75 (2V5), U302.88, U302.92, U303.8 (VDD), U303.24 (VDD), X301.4 (V+); also elsewhere on the board
/FPGA/BLU_B0: U302.40 (IO41); also elsewhere on the board
/FPGA/BLU_B1: U302.37 (IO37); also elsewhere on the board
/FPGA/GRN_B0: U302.36 (IO34); also elsewhere on the board
/FPGA/GRN_B1: U302.34 (IO36_GB4); also elsewhere on the board
/FPGA/LV_A0: U302.99 (IO93); also elsewhere on the board
/FPGA/LV_A1: U302.100 (IO95); also elsewhere on the board
/FPGA/LV_A2: U302.95 (IO89); also elsewhere on the board
/FPGA/LV_A3: U302.97 (IO91); also elsewhere on the board
/FPGA/LV_D0: U302.10 (IO5B); also elsewhere on the board
/FPGA/LV_D1: U302.9 (IO5A); also elsewhere on the board
/FPGA/LV_D2: U302.8 (IO3B); also elsewhere on the board
/FPGA/LV_D3: U302.7 (IO3A); also elsewhere on the board
/FPGA/LV_D4: U302.4 (IO2B); also elsewhere on the board
/FPGA/LV_D5: U302.3 (IO2A); also elsewhere on the board
/FPGA/LV_D6: U302.2 (IO1B); also elsewhere on the board
/FPGA/LV_D7: U302.1 (IO1A); also elsewhere on the board
/FPGA/RED_B0: U302.33 (IO35_GB5); also elsewhere on the board
/FPGA/RED_B1: U302.30 (IO30); also elsewhere on the board
/FPGA/VRAM_A0: U302.69 (IO68), U303.1 (A0)
/FPGA/VRAM_A1: U302.71 (IO69), U303.2 (A1)
/FPGA/VRAM_A2: U302.72 (IO70), U303.3 (A2)
/FPGA/VRAM_A3: U302.73 (IO71), U303.4 (A3)
/FPGA/VRAM_A4: U302.83 (IO79), U303.13 (A4)
/FPGA/VRAM_A5: U302.85 (IO80), U303.14 (A5)
/FPGA/VRAM_A6: U302.86 (IO81), U303.15 (A6)
/FPGA/VRAM_A7: U302.87 (IO82), U303.16 (A7)
/FPGA/VRAM_A8: U302.68 (IO67), U303.17 (A8)
/FPGA/VRAM_A9: U302.66 (IO65), U303.18 (A9)
/FPGA/VRAM_A10: U302.65 (IO64), U303.19 (A10)
/FPGA/VRAM_A11: U302.64 (IO63), U303.20 (A11)
/FPGA/VRAM_A12: U302.63 (IO61_GB2), U303.21 (A12)
/FPGA/VRAM_A13: U302.54 (IO55), U303.29 (A13)
/FPGA/VRAM_A14: U302.53 (IO54), U303.30 (A14)
/FPGA/VRAM_A15: U302.52 (IO53), U303.31 (A15)
/FPGA/VRAM_A16: U302.51 (IO52), U303.32 (A16)
/FPGA/VRAM_D0: U302.78 (IO73), U303.6 (I/O0)
/FPGA/VRAM_D1: U302.79 (IO74), U303.7 (I/O1)
/FPGA/VRAM_D2: U302.80 (IO75), U303.10 (I/O2)
/FPGA/VRAM_D3: U302.81 (IO77), U303.11 (I/O3)
/FPGA/VRAM_D4: U302.62 (IO60_GB3), U303.22 (I/O4)
/FPGA/VRAM_D5: U302.60 (IO59), U303.23 (I/O5)
/FPGA/VRAM_D6: U302.59 (IO58), U303.26 (I/O6)
/FPGA/VRAM_D7: U302.57 (IO57), U303.27 (I/O7)
/FPGA/~D_EN: U302.12 (IO6A); also elsewhere on the board
/FPGA/~HSYNC: U302.41 (CBS0_IO42); also elsewhere on the board
/FPGA/~INT: U302.96 (IO90); also elsewhere on the board
/FPGA/~LV_RD: U302.93 (IO87); also elsewhere on the board
/FPGA/~LV_WR: U302.94 (IO88); also elsewhere on the board
/FPGA/~RST: D302.1 (K); also elsewhere on the board
/FPGA/~VGA_EN: U302.29 (IO29); also elsewhere on the board
/FPGA/~VRAM_CE: R302.2, U302.74 (IO72), U303.5 (~CE)
/FPGA/~VRAM_OE: U302.56 (IO56), U303.28 (~OE)
/FPGA/~VRAM_WE: U302.82 (IO78), U303.12 (~WE)
/FPGA/~VSYNC: U302.42 (CBS1_IO43); also elsewhere on the board
GND: C301.1, C302.2, C303.1, C304.2, C305.1, C306.1, C307.1, C308.1, C309.1, C310.1, C311.1, C312.2, C313.1, C314.2, C315.1, C316.2, C317.2, C318.1, C319.1, C320.1, J301.2, R306.2, R308.2, R309.2, SW301.2, U301.4 (GND), U302.5, U302.17, U302.23, U302.32, U302.39, U302.47, U302.55, U302.70, U302.84, U302.98, U303.9 (GND), U303.25 (GND), X301.2 (GND); also elsewhere on the board
unnamed: C314.1, D302.2 (A), J301.6, R307.2, SW301.1, U302.44 (RST)
unnamed: D301.1 (K), R306.1
unnamed: D301.2 (A), J301.5, R305.2, U302.43 (DONE)
unnamed: D303.1 (K), R308.1
unnamed: D303.2 (A), U302.26 (IO26)
unnamed: D304.1 (K), R309.1
unnamed: D304.2 (A), U302.27 (IO27)
unnamed: J301.1, JP301.1 (A)
unnamed: J301.7, U301.2 (DO(IO1)), U302.46 (SDI)
unnamed: J301.8, U301.5 (DI(IO0)), U302.45 (SDO)
unnamed: J301.9, R303.2, U301.6 (CLK), U302.48 (SCK)
unnamed: J301.10, R304.2, U301.1 (~CS), U302.49 (SS)
unnamed: R301.2, U301.3 (IO2), U301.7 (IO3)
unnamed: U302.90 (GB0_IO85), X301.3 (OUT)

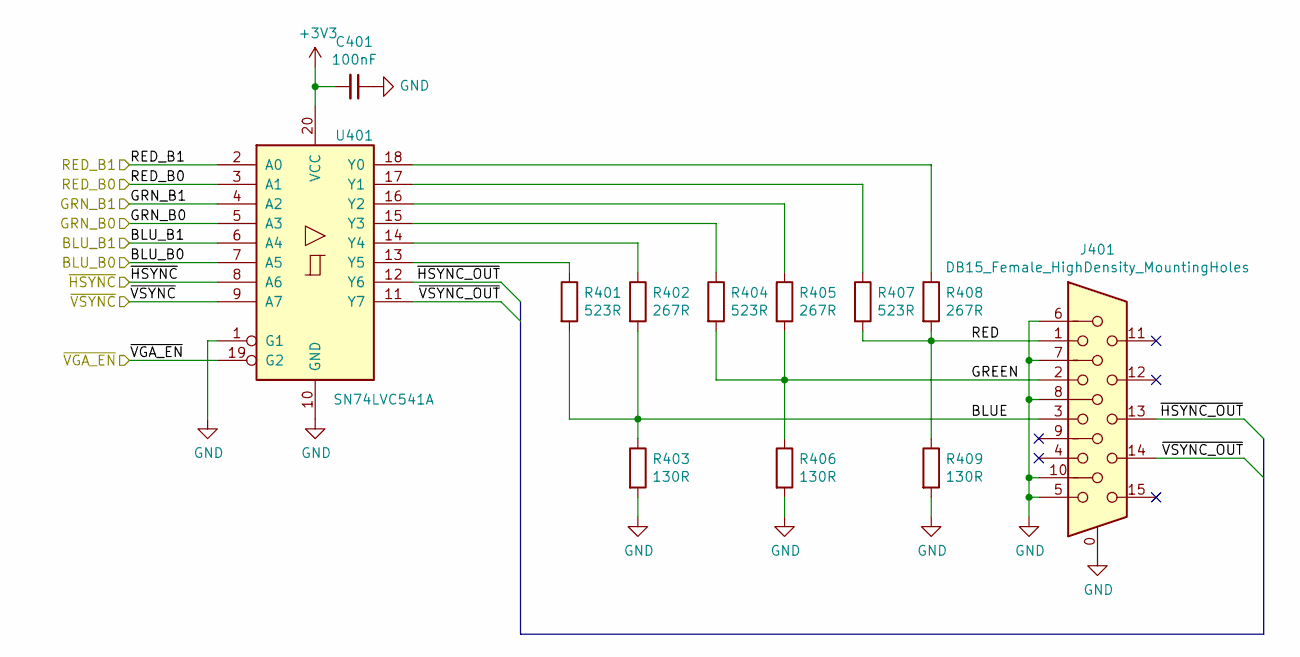
[picture p8: schematic output.sch]

Parts:
C401: 100nF; C_0805_2012Metric_Pad1.15x1.40mm_HandSolder
J401: DB15_Female_HighDensity_MountingHoles; DSUB-15-HD_Female_Horizontal_P2.29x1.98mm_EdgePinOffset3.03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
R401, R404, R407: 523R; R_0805_2012Metric_Pad1.15x1.40mm_HandSolder
R402, R405, R408: 267R; R_0805_2012Metric_Pad1.15x1.40mm_HandSolder
R403, R406, R409: 130R; R_0805_2012Metric_Pad1.15x1.40mm_HandSolder
U401: SN74LVC541A; SOIC-20W_7.5x12.8mm_P1.27mm

Connections:
+3V3: C401.2, U401.20 (VCC); also elsewhere on the board
/FPGA/BLU_B0: U401.7 (A5); also elsewhere on the board
/FPGA/BLU_B1: U401.6 (A4); also elsewhere on the board
/FPGA/GRN_B0: U401.5 (A3); also elsewhere on the board
/FPGA/GRN_B1: U401.4 (A2); also elsewhere on the board
/FPGA/RED_B0: U401.3 (A1); also elsewhere on the board
/FPGA/RED_B1: U401.2 (A0); also elsewhere on the board
/FPGA/~HSYNC: U401.8 (A6); also elsewhere on the board
/FPGA/~VGA_EN: U401.19 (G2); also elsewhere on the board
/FPGA/~VSYNC: U401.9 (A7); also elsewhere on the board
/Output/BLUE: J401.3, R401.2, R402.2, R403.1
/Output/GREEN: J401.2, R404.2, R405.2, R406.1
/Output/RED: J401.1, R407.2, R408.2, R409.1
/Output/~HSYNC_OUT: J401.13, U401.12 (Y6)
/Output/~VSYNC_OUT: J401.14, U401.11 (Y7)
GND: C401.1, J401.0, J401.5, J401.6, J401.7, J401.8, J401.10, R403.2, R406.2, R409.2, U401.1 (G1), U401.10 (GND); also elsewhere on the board
unnamed: R401.1, U401.13 (Y5)
unnamed: R402.1, U401.14 (Y4)
unnamed: R404.1, U401.15 (Y3)
unnamed: R405.1, U401.16 (Y2)
unnamed: R407.1, U401.17 (Y1)
unnamed: R408.1, U401.18 (Y0)

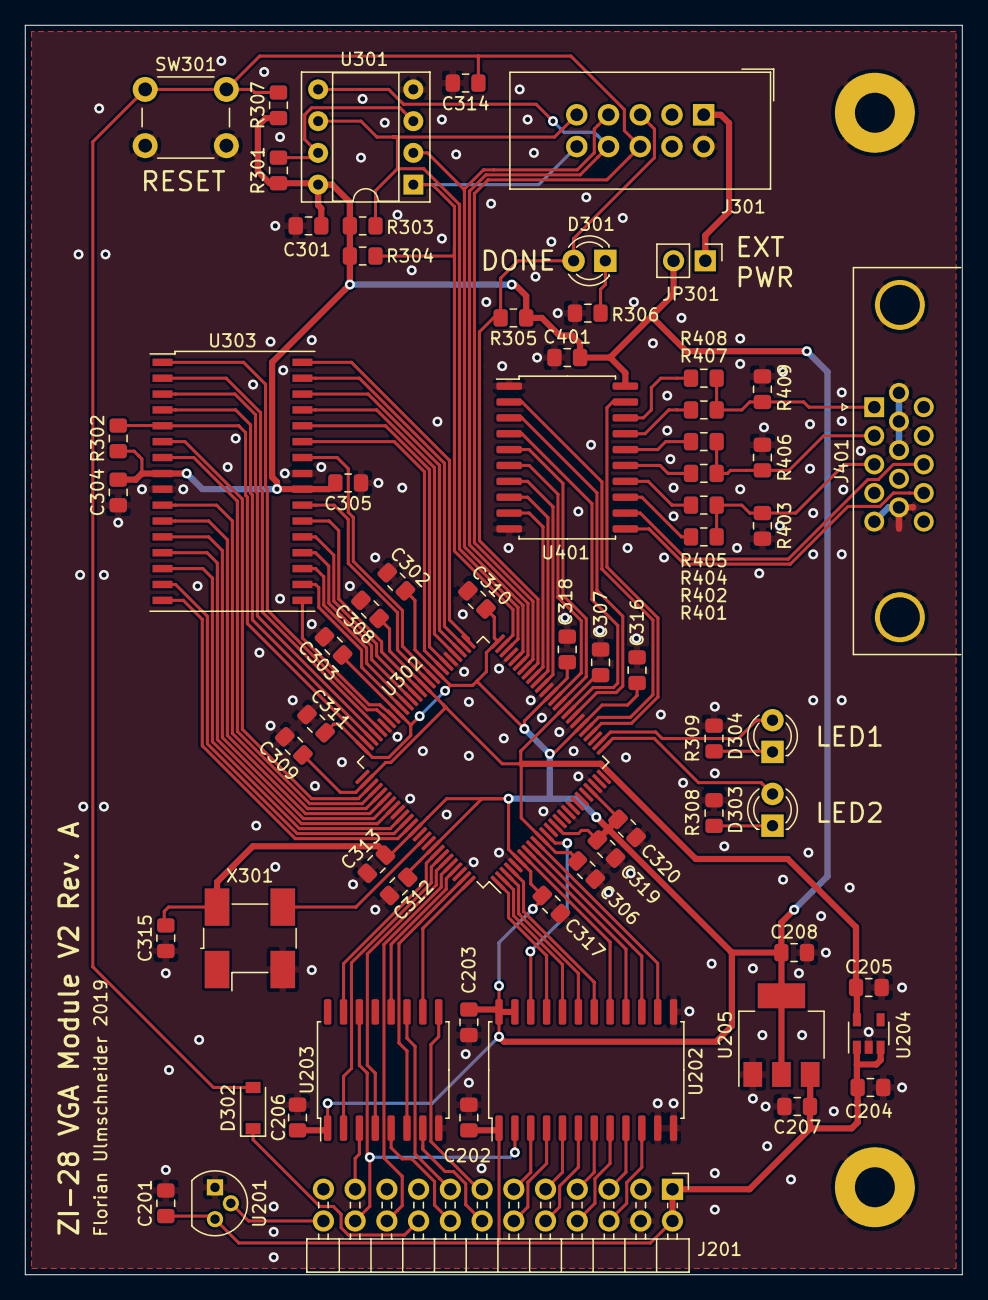
[picture p9: board vga-v2.kicad_pcb from above]

Board: 2 copper layers, 75.0 x 100.0 mm, 68 parts (0 on the bottom side), 98 nets.
