fulmsch/ZI28/hardware/modules/vga/vga.kicad_pcb

## KiCad design hardware/modules/vga/vga.kicad_pcb (2019-06-14, an earlier design)

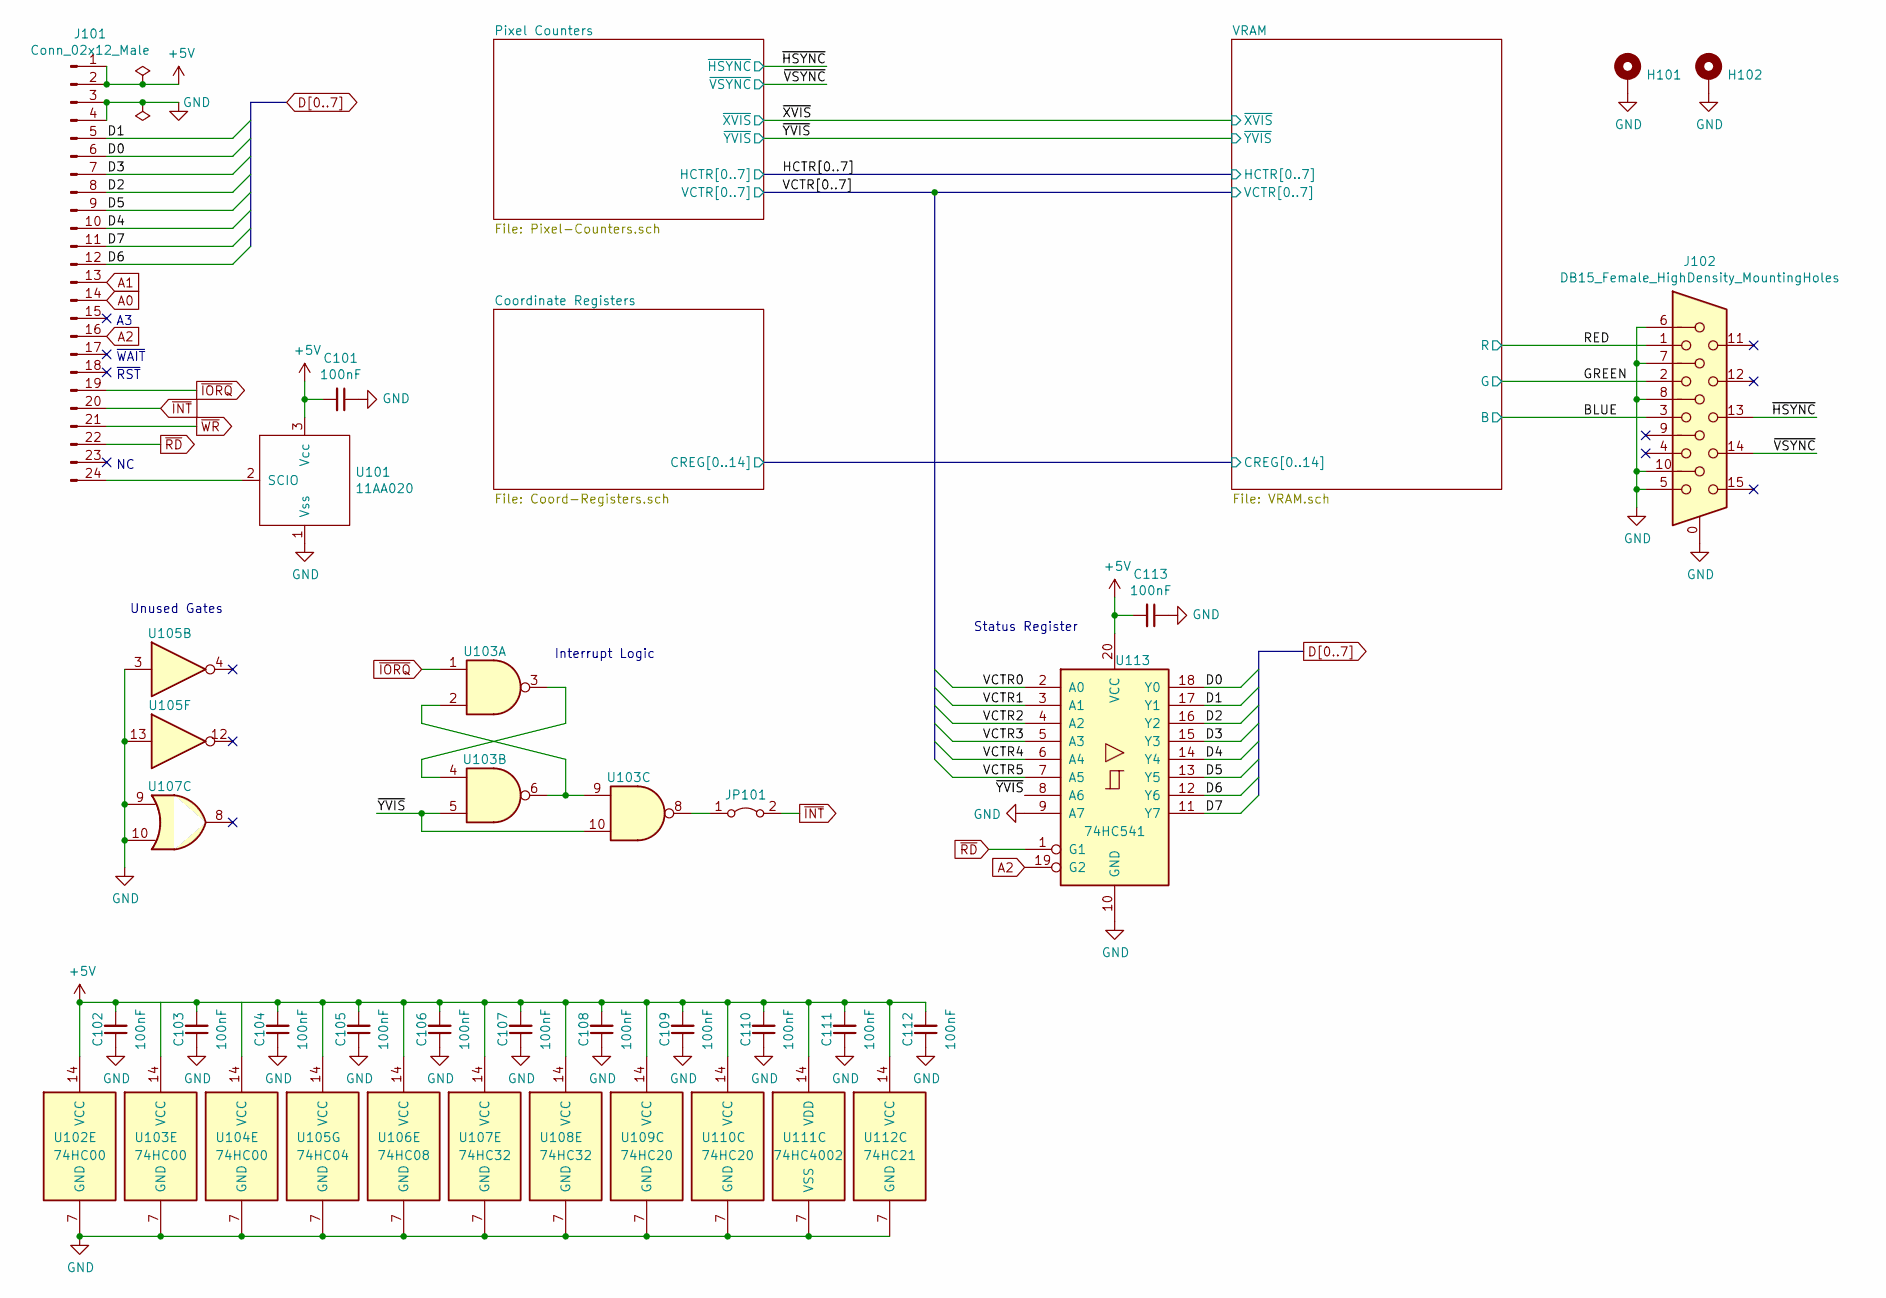
[picture p10: schematic vga.sch, ZI-28 VGA Module]

Parts:
C101, C102, C103, C104, C105, C106, C107, C108, C109, C110, C111, C112, C113: 100nF; C_Disc_D3.0mm_W1.6mm_P2.50mm
H101, H102: MountingHole_Pad; MountingHole_3.2mm_M3_Pad
J101: Conn_02x12_Male; PinHeader_2x12_P2.54mm_Horizontal
J102: DB15_Female_HighDensity_MountingHoles; DSUB-15-HD_Female_Horizontal_P2.29x1.98mm_EdgePinOffset3.03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
JP101: Jumper_2_Bridged; PinHeader_1x02_P2.54mm_Vertical
U101: 11AA020; TO-92
U102, U103, U104: 74HC00; DIP-14_W7.62mm_Socket
U105: 74HC04; DIP-14_W7.62mm_Socket
U106: 74HC08; DIP-14_W7.62mm_Socket
U107, U108: 74HC32; DIP-14_W7.62mm_Socket
U109, U110: 74HC20; DIP-14_W7.62mm_Socket
U111: 74HC4002; DIP-14_W7.62mm_Socket
U112: 74HC21; DIP-14_W7.62mm_Socket
U113: 74HC541; DIP-20_W7.62mm_Socket

Connections:
+5V: C101.2, C102.2, C103.2, C104.2, C105.2, C106.2, C107.2, C108.2, C109.2, C110.2, C111.2, C112.2, C113.2, J101.1, J101.2, U101.3 (Vcc), U102.14 (VCC), U103.14 (VCC), U104.14 (VCC), U105.14 (VCC), U106.14 (VCC), U107.14 (VCC), U108.14 (VCC), U109.14 (VCC), U110.14 (VCC), U111.14 (VDD), U112.14 (VCC), U113.20 (VCC); also elsewhere on the board
/BLUE: J102.3; also elsewhere on the board
/GREEN: J102.2; also elsewhere on the board
/RED: J102.1; also elsewhere on the board
/VCTR0: U113.2 (A0); also elsewhere on the board
/VCTR1: U113.3 (A1); also elsewhere on the board
/VCTR2: U113.4 (A2); also elsewhere on the board
/VCTR3: U113.5 (A3); also elsewhere on the board
/VCTR4: U113.6 (A4); also elsewhere on the board
/VCTR5: U113.7 (A5); also elsewhere on the board
/~HSYNC: J102.13; also elsewhere on the board
/~VSYNC: J102.14; also elsewhere on the board
/~YVIS: U103.5, U103.10, U113.8 (A6); also elsewhere on the board
A0: J101.14; also elsewhere on the board
A1: J101.13; also elsewhere on the board
A2: J101.16, U113.19 (G2); also elsewhere on the board
D0: J101.6, U113.18 (Y0); also elsewhere on the board
D1: J101.5, U113.17 (Y1); also elsewhere on the board
D2: J101.8, U113.16 (Y2); also elsewhere on the board
D3: J101.7, U113.15 (Y3); also elsewhere on the board
D4: J101.10, U113.14 (Y4); also elsewhere on the board
D5: J101.9, U113.13 (Y5); also elsewhere on the board
D6: J101.12, U113.12 (Y6); also elsewhere on the board
D7: J101.11, U113.11 (Y7); also elsewhere on the board
GND: C101.1, C102.1, C103.1, C104.1, C105.1, C106.1, C107.1, C108.1, C109.1, C110.1, C111.1, C112.1, C113.1, H101.1, H102.1, J101.3, J101.4, J102.0, J102.5, J102.6, J102.7, J102.8, J102.10, U101.1 (Vss), U102.7 (GND), U103.7 (GND), U104.7 (GND), U105.3, U105.7 (GND), U105.13, U106.7 (GND), U107.7 (GND), U107.9, U107.10, U108.7 (GND), U109.7 (GND), U110.7 (GND), U111.7 (VSS), U112.7 (GND), U113.9 (A7), U113.10 (GND); also elsewhere on the board
unnamed: J101.24, U101.2 (SCIO)
unnamed: JP101.1 (A), U103.8
unnamed: U103.2, U103.6, U103.9
unnamed: U103.3, U103.4
~INT: J101.20, JP101.2 (B)
~IORQ: J101.19, U103.1; also elsewhere on the board
~RD: J101.22, U113.1 (G1)
~WR: J101.21; also elsewhere on the board

Notes on the sheet:
Status Register
Interrupt Logic
~WAIT
~RST
Unused Gates

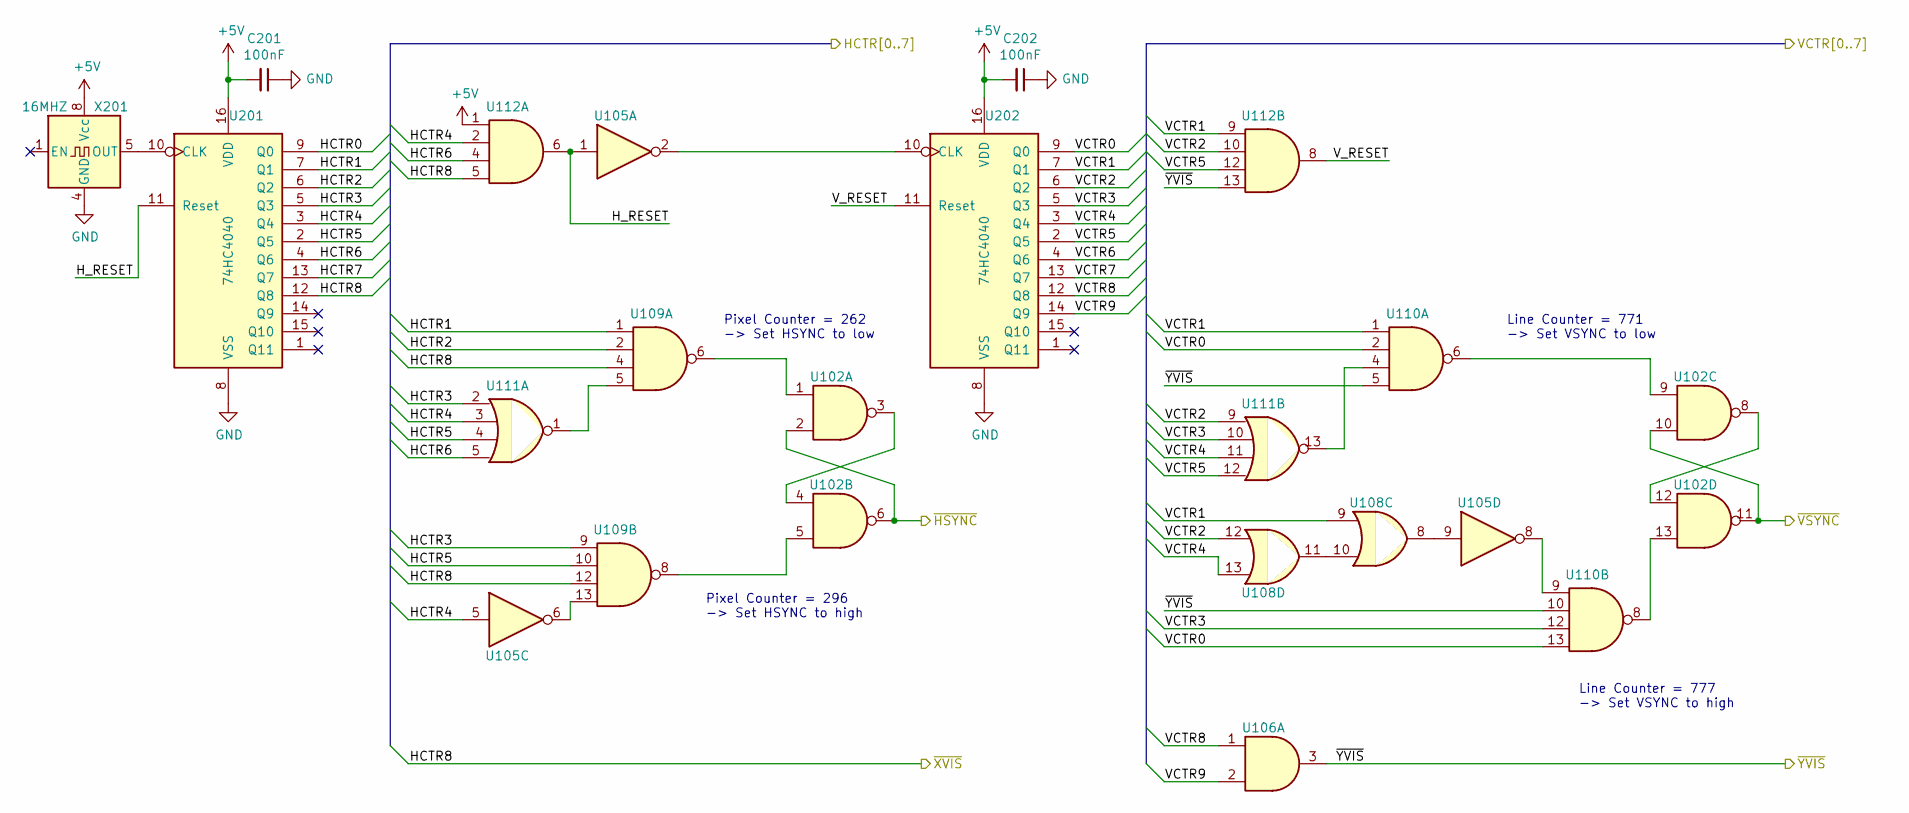
[picture p11: schematic Pixel-Counters.sch, ZI-28 VGA Module]

Parts:
C201, C202: 100nF; C_Disc_D3.0mm_W1.6mm_P2.50mm
U102: 74HC00; DIP-14_W7.62mm_Socket
U105: 74HC04; DIP-14_W7.62mm_Socket
U106: 74HC08; DIP-14_W7.62mm_Socket
U108: 74HC32; DIP-14_W7.62mm_Socket
U109, U110: 74HC20; DIP-14_W7.62mm_Socket
U111: 74HC4002; DIP-14_W7.62mm_Socket
U112: 74HC21; DIP-14_W7.62mm_Socket
U201, U202: 74HC4040; DIP-16_W7.62mm_Socket
X201: 16MHZ; DIP-8_W7.62mm_Socket

Connections:
+5V: C201.2, C202.2, U112.1, U201.16 (VDD), U202.16 (VDD), X201.8 (Vcc); also elsewhere on the board
/Pixel Counters/HCTR0: U201.9 (Q0); also elsewhere on the board
/Pixel Counters/HCTR1: U109.1, U201.7 (Q1); also elsewhere on the board
/Pixel Counters/HCTR2: U109.2, U201.6 (Q2); also elsewhere on the board
/Pixel Counters/HCTR3: U109.9, U111.2, U201.5 (Q3); also elsewhere on the board
/Pixel Counters/HCTR4: U105.5, U111.3, U112.2, U201.3 (Q4); also elsewhere on the board
/Pixel Counters/HCTR5: U109.10, U111.4, U201.2 (Q5); also elsewhere on the board
/Pixel Counters/HCTR6: U111.5, U112.4, U201.4 (Q6); also elsewhere on the board
/Pixel Counters/HCTR7: U201.13 (Q7); also elsewhere on the board
/Pixel Counters/H_RESET: U105.1, U112.6, U201.11 (Reset)
/Pixel Counters/VCTR6: U202.4 (Q6); also elsewhere on the board
/Pixel Counters/VCTR7: U202.13 (Q7); also elsewhere on the board
/Pixel Counters/VCTR8: U106.1, U202.12 (Q8)
/Pixel Counters/VCTR9: U106.2, U202.14 (Q9)
/Pixel Counters/V_RESET: U112.8, U202.11 (Reset)
/VCTR0: U110.2, U110.13, U202.9 (Q0); also elsewhere on the board
/VCTR1: U108.9, U110.1, U112.9, U202.7 (Q1); also elsewhere on the board
/VCTR2: U108.12, U111.9, U112.10, U202.6 (Q2); also elsewhere on the board
/VCTR3: U110.12, U111.10, U202.5 (Q3); also elsewhere on the board
/VCTR4: U108.13, U111.11, U202.3 (Q4); also elsewhere on the board
/VCTR5: U111.12, U112.12, U202.2 (Q5); also elsewhere on the board
/~HSYNC: U102.2, U102.6; also elsewhere on the board
/~VSYNC: U102.10, U102.11; also elsewhere on the board
/~XVIS: U109.4, U109.12, U112.5, U201.12 (Q8); also elsewhere on the board
/~YVIS: U106.3, U110.5, U110.10, U112.13; also elsewhere on the board
GND: C201.1, C202.1, U201.8 (VSS), U202.8 (VSS), X201.4 (GND); also elsewhere on the board
unnamed: U102.1, U109.6
unnamed: U102.3, U102.4
unnamed: U102.5, U109.8
unnamed: U102.9, U110.6
unnamed: U102.8, U102.12
unnamed: U102.13, U110.8
unnamed: U105.2, U202.10 (CLK)
unnamed: U105.6, U109.13
unnamed: U105.8, U110.9
unnamed: U105.9, U108.8
unnamed: U108.10, U108.11
unnamed: U109.5, U111.1
unnamed: U110.4, U111.13
unnamed: U201.10 (CLK), X201.5 (OUT)

Notes on the sheet:
Pixel Counter = 296 -> Set HSYNC to high
Pixel Counter = 262 -> Set HSYNC to low
Line Counter = 771 -> Set VSYNC to low
Line Counter = 777 -> Set VSYNC to high
