fulmsch/ZI28/hardware/modules/vga/vga.kicad_pcb

## KiCad design hardware/modules/vga/vga.kicad_pcb (continued)

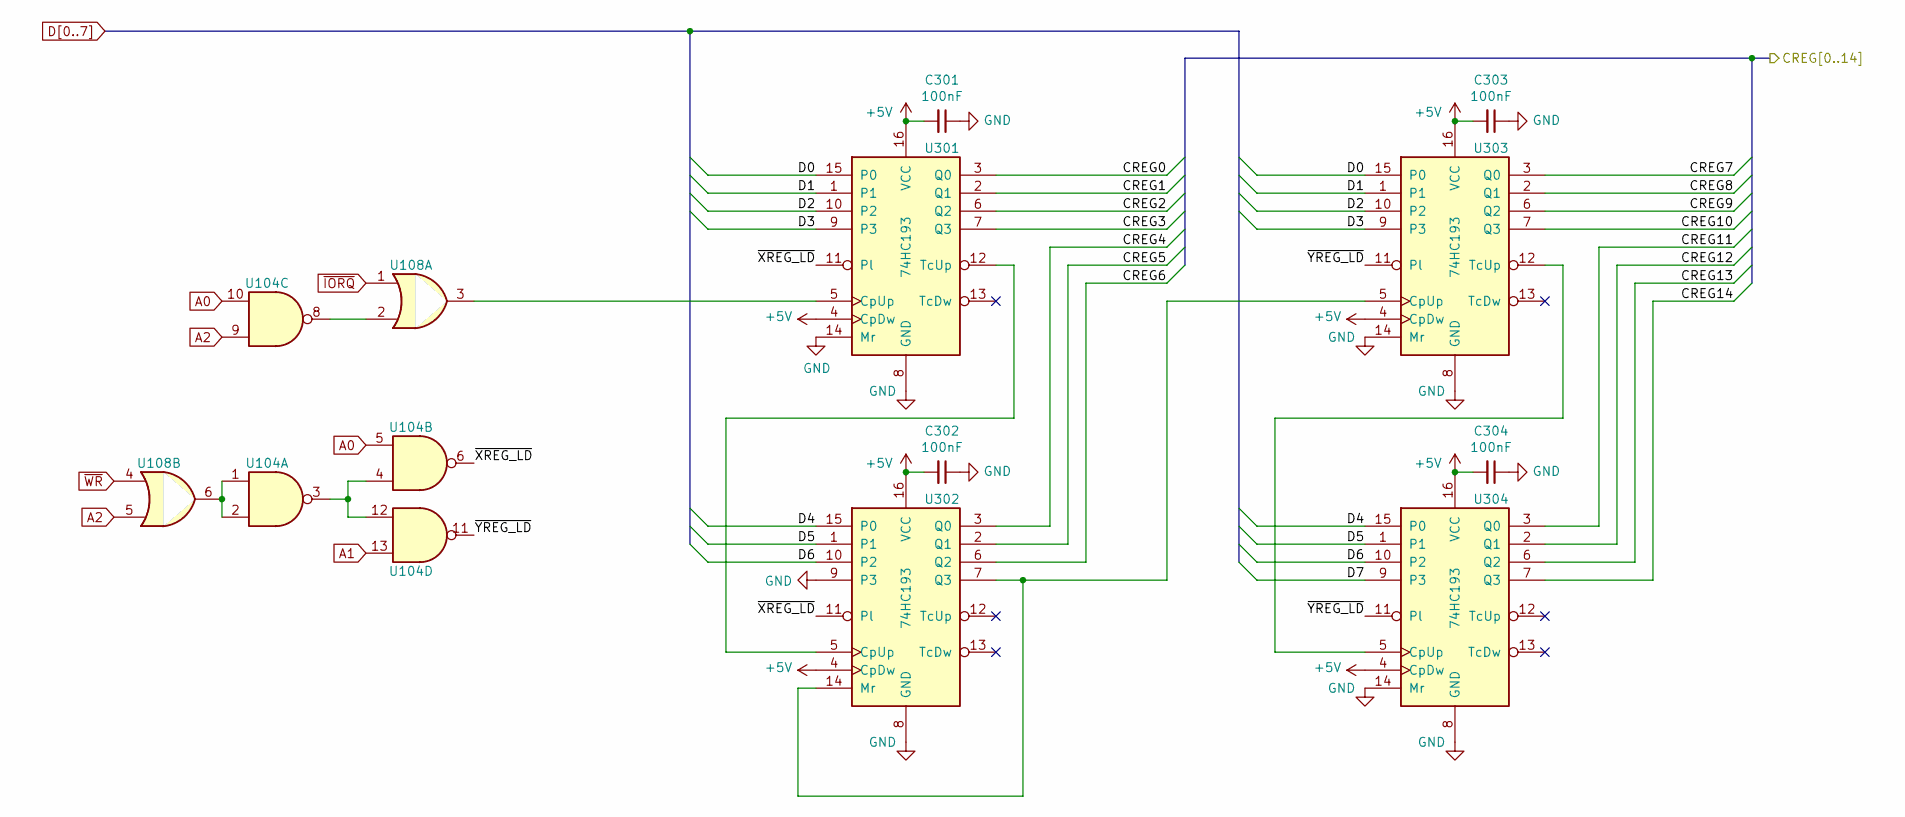
[picture p12: schematic Coord-Registers.sch, ZI-28 VGA Module]

Parts:
C301, C302, C303, C304: 100nF; C_Disc_D3.0mm_W1.6mm_P2.50mm
U104: 74HC00; DIP-14_W7.62mm_Socket
U108: 74HC32; DIP-14_W7.62mm_Socket
U301, U302, U303, U304: 74HC193; DIP-16_W7.62mm_Socket

Connections:
+5V: C301.2, C302.2, C303.2, C304.2, U301.4 (CpDw), U301.16 (VCC), U302.4 (CpDw), U302.16 (VCC), U303.4 (CpDw), U303.16 (VCC), U304.4 (CpDw), U304.16 (VCC); also elsewhere on the board
/Coordinate Registers/CREG0: U301.3 (Q0); also elsewhere on the board
/Coordinate Registers/CREG1: U301.2 (Q1); also elsewhere on the board
/Coordinate Registers/CREG2: U301.6 (Q2); also elsewhere on the board
/Coordinate Registers/CREG3: U301.7 (Q3); also elsewhere on the board
/Coordinate Registers/CREG4: U302.3 (Q0); also elsewhere on the board
/Coordinate Registers/CREG5: U302.2 (Q1); also elsewhere on the board
/Coordinate Registers/CREG6: U302.6 (Q2); also elsewhere on the board
/Coordinate Registers/CREG7: U303.3 (Q0); also elsewhere on the board
/Coordinate Registers/CREG8: U303.2 (Q1); also elsewhere on the board
/Coordinate Registers/CREG9: U303.6 (Q2); also elsewhere on the board
/Coordinate Registers/CREG10: U303.7 (Q3); also elsewhere on the board
/Coordinate Registers/CREG11: U304.3 (Q0); also elsewhere on the board
/Coordinate Registers/CREG12: U304.2 (Q1); also elsewhere on the board
/Coordinate Registers/CREG13: U304.6 (Q2); also elsewhere on the board
/Coordinate Registers/CREG14: U304.7 (Q3); also elsewhere on the board
/Coordinate Registers/~XREG_LD: U104.6, U301.11 (Pl), U302.11 (Pl)
/Coordinate Registers/~YREG_LD: U104.11, U303.11 (Pl), U304.11 (Pl)
A0: U104.5, U104.10; also elsewhere on the board
A1: U104.13; also elsewhere on the board
A2: U104.9, U108.5; also elsewhere on the board
D0: U301.15 (P0), U303.15 (P0); also elsewhere on the board
D1: U301.1, U303.1; also elsewhere on the board
D2: U301.10 (P2), U303.10 (P2); also elsewhere on the board
D3: U301.9 (P3), U303.9 (P3); also elsewhere on the board
D4: U302.15 (P0), U304.15 (P0); also elsewhere on the board
D5: U302.1, U304.1; also elsewhere on the board
D6: U302.10 (P2), U304.10 (P2); also elsewhere on the board
D7: U304.9 (P3); also elsewhere on the board
GND: C301.1, C302.1, C303.1, C304.1, U301.8 (GND), U301.14 (Mr), U302.8 (GND), U302.9 (P3), U303.8 (GND), U303.14 (Mr), U304.8 (GND), U304.14 (Mr); also elsewhere on the board
unnamed: U104.1, U104.2, U108.6
unnamed: U104.8, U108.2
unnamed: U104.3, U104.4, U104.12
unnamed: U108.3, U301.5 (CpUp)
unnamed: U301.12 (TcUp), U302.5 (CpUp)
unnamed: U302.7 (Q3), U302.14 (Mr), U303.5 (CpUp)
unnamed: U303.12 (TcUp), U304.5 (CpUp)
~IORQ: U108.1; also elsewhere on the board
~WR: U108.4; also elsewhere on the board

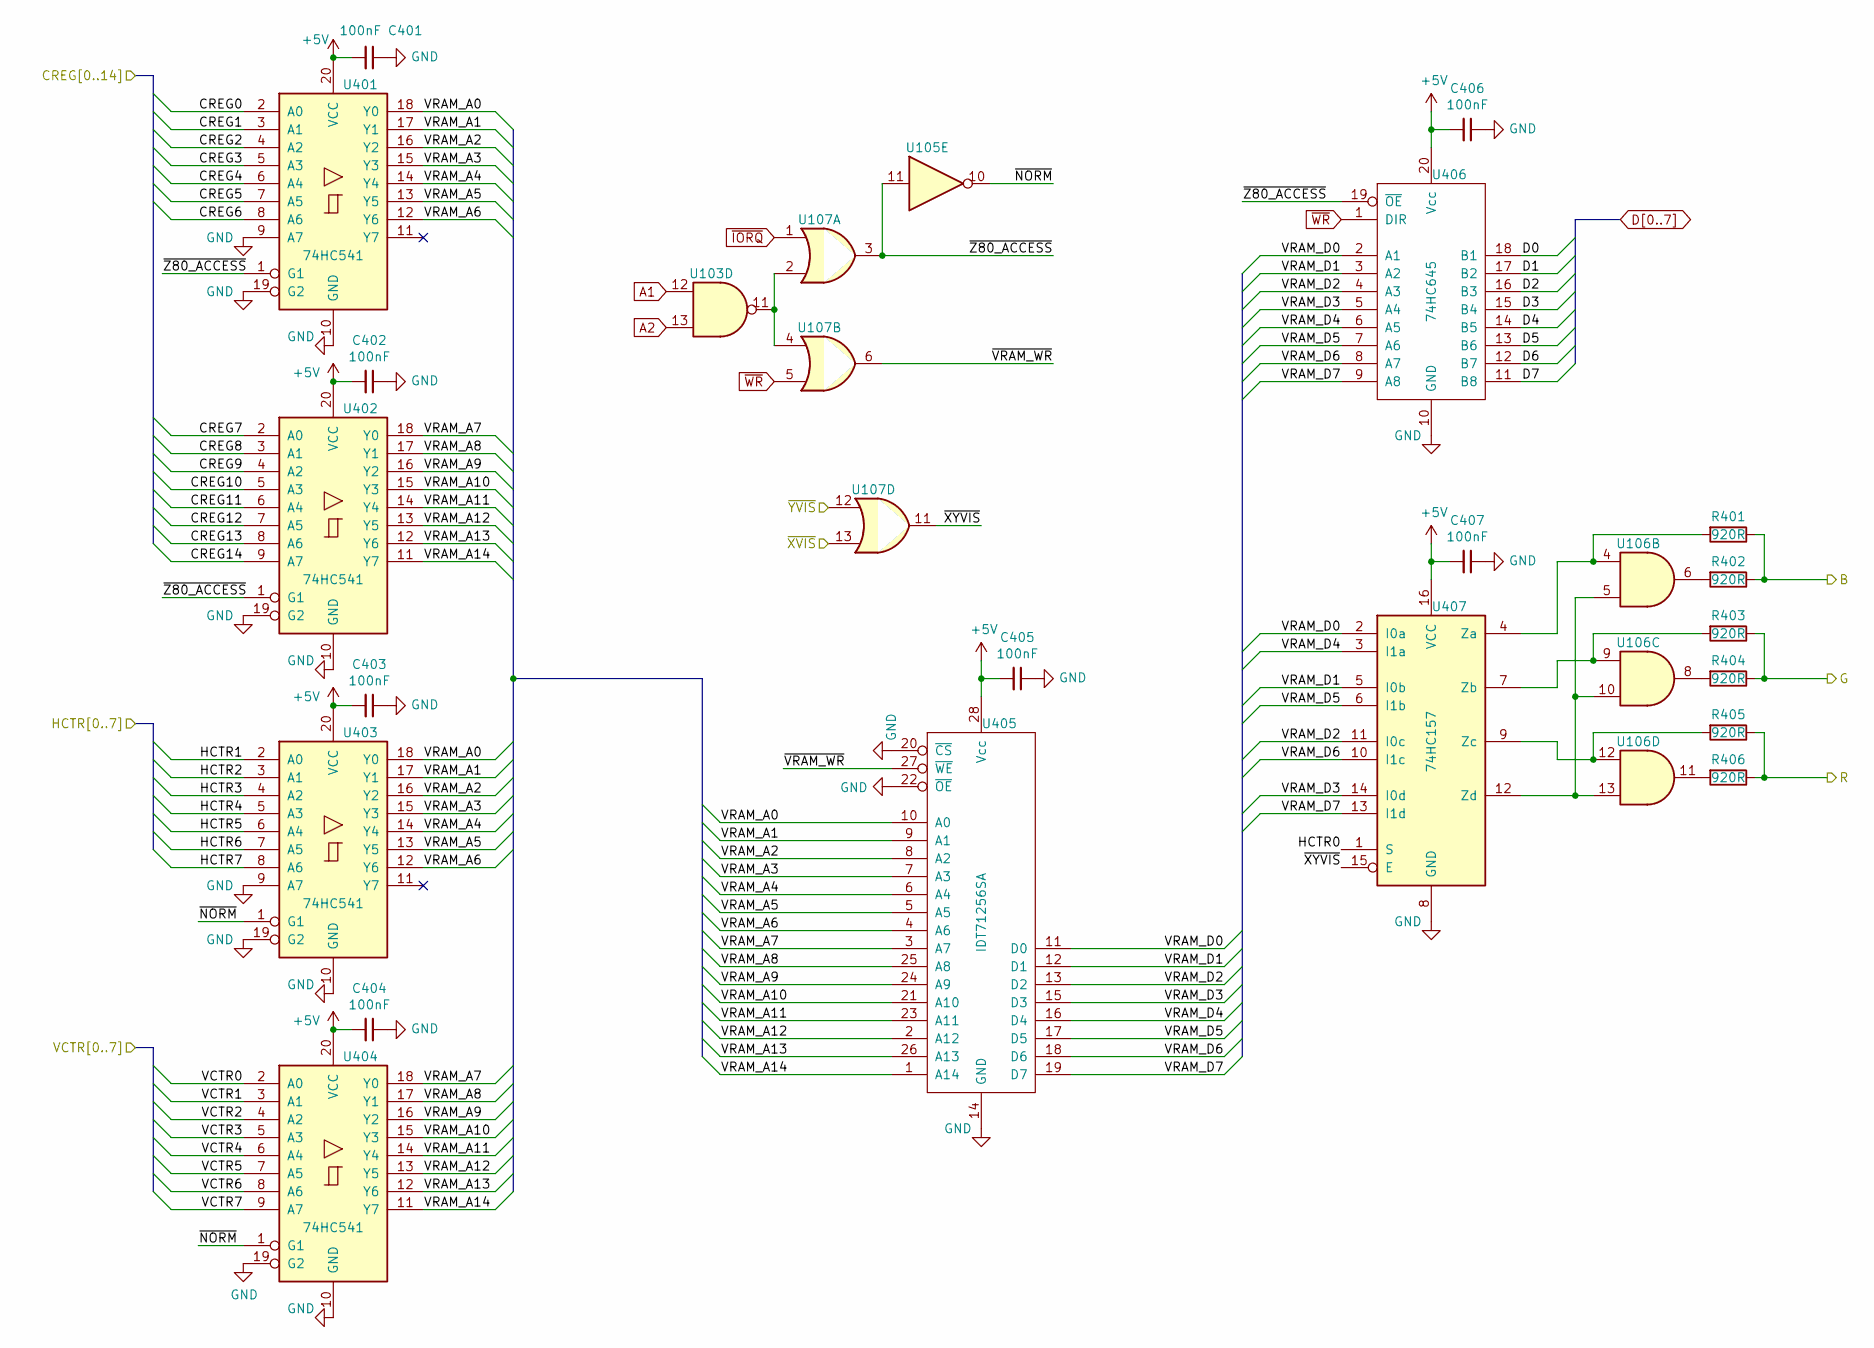
[picture p13: schematic VRAM.sch, ZI-28 VGA Module]

Parts:
C401, C402, C403, C404, C405, C406, C407: 100nF; C_Disc_D3.0mm_W1.6mm_P2.50mm
R401, R402, R403, R404, R405, R406: 920R; R_Axial_DIN0207_L6.3mm_D2.5mm_P2.54mm_Vertical
U103: 74HC00; DIP-14_W7.62mm_Socket
U105: 74HC04; DIP-14_W7.62mm_Socket
U106: 74HC08; DIP-14_W7.62mm_Socket
U107: 74HC32; DIP-14_W7.62mm_Socket
U401, U402, U403, U404: 74HC541; DIP-20_W7.62mm_Socket
U405: IDT71256SA; DIP-28_W7.62mm_Socket
U406: 74HC645; DIP-20_W7.62mm_Socket
U407: 74HC157; DIP-16_W7.62mm_Socket

Connections:
+5V: C401.2, C402.2, C403.2, C404.2, C405.2, C406.2, C407.2, U401.20 (VCC), U402.20 (VCC), U403.20 (VCC), U404.20 (VCC), U405.28 (Vcc), U406.20 (Vcc), U407.16 (VCC); also elsewhere on the board
/BLUE: R401.1, R402.1; also elsewhere on the board
/Coordinate Registers/CREG0: U401.2 (A0); also elsewhere on the board
/Coordinate Registers/CREG1: U401.3 (A1); also elsewhere on the board
/Coordinate Registers/CREG2: U401.4 (A2); also elsewhere on the board
/Coordinate Registers/CREG3: U401.5 (A3); also elsewhere on the board
/Coordinate Registers/CREG4: U401.6 (A4); also elsewhere on the board
/Coordinate Registers/CREG5: U401.7 (A5); also elsewhere on the board
/Coordinate Registers/CREG6: U401.8 (A6); also elsewhere on the board
/Coordinate Registers/CREG7: U402.2 (A0); also elsewhere on the board
/Coordinate Registers/CREG8: U402.3 (A1); also elsewhere on the board
/Coordinate Registers/CREG9: U402.4 (A2); also elsewhere on the board
/Coordinate Registers/CREG10: U402.5 (A3); also elsewhere on the board
/Coordinate Registers/CREG11: U402.6 (A4); also elsewhere on the board
/Coordinate Registers/CREG12: U402.7 (A5); also elsewhere on the board
/Coordinate Registers/CREG13: U402.8 (A6); also elsewhere on the board
/Coordinate Registers/CREG14: U402.9 (A7); also elsewhere on the board
/GREEN: R403.1, R404.1; also elsewhere on the board
/Pixel Counters/HCTR0: U407.1 (S); also elsewhere on the board
/Pixel Counters/HCTR1: U403.2 (A0); also elsewhere on the board
/Pixel Counters/HCTR2: U403.3 (A1); also elsewhere on the board
/Pixel Counters/HCTR3: U403.4 (A2); also elsewhere on the board
/Pixel Counters/HCTR4: U403.5 (A3); also elsewhere on the board
/Pixel Counters/HCTR5: U403.6 (A4); also elsewhere on the board
/Pixel Counters/HCTR6: U403.7 (A5); also elsewhere on the board
/Pixel Counters/HCTR7: U403.8 (A6); also elsewhere on the board
/Pixel Counters/VCTR6: U404.8 (A6); also elsewhere on the board
/Pixel Counters/VCTR7: U404.9 (A7); also elsewhere on the board
/RED: R405.1, R406.1; also elsewhere on the board
/VCTR0: U404.2 (A0); also elsewhere on the board
/VCTR1: U404.3 (A1); also elsewhere on the board
/VCTR2: U404.4 (A2); also elsewhere on the board
/VCTR3: U404.5 (A3); also elsewhere on the board
/VCTR4: U404.6 (A4); also elsewhere on the board
/VCTR5: U404.7 (A5); also elsewhere on the board
/VRAM/VRAM_A0: U401.18 (Y0), U403.18 (Y0), U405.10 (A0)
/VRAM/VRAM_A1: U401.17 (Y1), U403.17 (Y1), U405.9 (A1)
/VRAM/VRAM_A2: U401.16 (Y2), U403.16 (Y2), U405.8 (A2)
/VRAM/VRAM_A3: U401.15 (Y3), U403.15 (Y3), U405.7 (A3)
/VRAM/VRAM_A4: U401.14 (Y4), U403.14 (Y4), U405.6 (A4)
/VRAM/VRAM_A5: U401.13 (Y5), U403.13 (Y5), U405.5 (A5)
/VRAM/VRAM_A6: U401.12 (Y6), U403.12 (Y6), U405.4 (A6)
/VRAM/VRAM_A7: U402.18 (Y0), U404.18 (Y0), U405.3 (A7)
/VRAM/VRAM_A8: U402.17 (Y1), U404.17 (Y1), U405.25 (A8)
/VRAM/VRAM_A9: U402.16 (Y2), U404.16 (Y2), U405.24 (A9)
/VRAM/VRAM_A10: U402.15 (Y3), U404.15 (Y3), U405.21 (A10)
/VRAM/VRAM_A11: U402.14 (Y4), U404.14 (Y4), U405.23 (A11)
/VRAM/VRAM_A12: U402.13 (Y5), U404.13 (Y5), U405.2 (A12)
/VRAM/VRAM_A13: U402.12 (Y6), U404.12 (Y6), U405.26 (A13)
/VRAM/VRAM_A14: U402.11 (Y7), U404.11 (Y7), U405.1 (A14)
/VRAM/VRAM_D0: U405.11 (D0), U406.2 (A1), U407.2 (I0a)
/VRAM/VRAM_D1: U405.12 (D1), U406.3 (A2), U407.5 (I0b)
/VRAM/VRAM_D2: U405.13 (D2), U406.4 (A3), U407.11 (I0c)
/VRAM/VRAM_D3: U405.15 (D3), U406.5 (A4), U407.14 (I0d)
/VRAM/VRAM_D4: U405.16 (D4), U406.6 (A5), U407.3 (I1a)
/VRAM/VRAM_D5: U405.17 (D5), U406.7 (A6), U407.6 (I1b)
/VRAM/VRAM_D6: U405.18 (D6), U406.8 (A7), U407.10 (I1c)
/VRAM/VRAM_D7: U405.19 (D7), U406.9 (A8), U407.13 (I1d)
/VRAM/~NORM: U105.10, U403.1 (G1), U404.1 (G1)
/VRAM/~VRAM_WR: U107.6, U405.27 (~WE)
/VRAM/~XYVIS: U107.11, U407.15 (E)
/VRAM/~Z80_ACCESS: U105.11, U107.3, U401.1 (G1), U402.1 (G1), U406.19 (~OE)
/~XVIS: U107.13; also elsewhere on the board
/~YVIS: U107.12; also elsewhere on the board
A1: U103.12; also elsewhere on the board
A2: U103.13; also elsewhere on the board
D0: U406.18 (B1); also elsewhere on the board
D1: U406.17 (B2); also elsewhere on the board
D2: U406.16 (B3); also elsewhere on the board
D3: U406.15 (B4); also elsewhere on the board
D4: U406.14 (B5); also elsewhere on the board
D5: U406.13 (B6); also elsewhere on the board
D6: U406.12 (B7); also elsewhere on the board
D7: U406.11 (B8); also elsewhere on the board
GND: C401.1, C402.1, C403.1, C404.1, C405.1, C406.1, C407.1, U401.9 (A7), U401.10 (GND), U401.19 (G2), U402.10 (GND), U402.19 (G2), U403.9 (A7), U403.10 (GND), U403.19 (G2), U404.10 (GND), U404.19 (G2), U405.14 (GND), U405.20 (~CS), U405.22 (~OE), U406.10 (GND), U407.8 (GND); also elsewhere on the board
unnamed: R401.2, U106.4, U407.4 (Za)
unnamed: R402.2, U106.6
unnamed: R403.2, U106.9, U407.7 (Zb)
unnamed: R404.2, U106.8
unnamed: R405.2, U106.12, U407.9 (Zc)
unnamed: R406.2, U106.11
unnamed: U103.11, U107.2, U107.4
unnamed: U106.5, U106.10, U106.13, U407.12 (Zd)
~IORQ: U107.1; also elsewhere on the board
~WR: U107.5, U406.1 (DIR); also elsewhere on the board

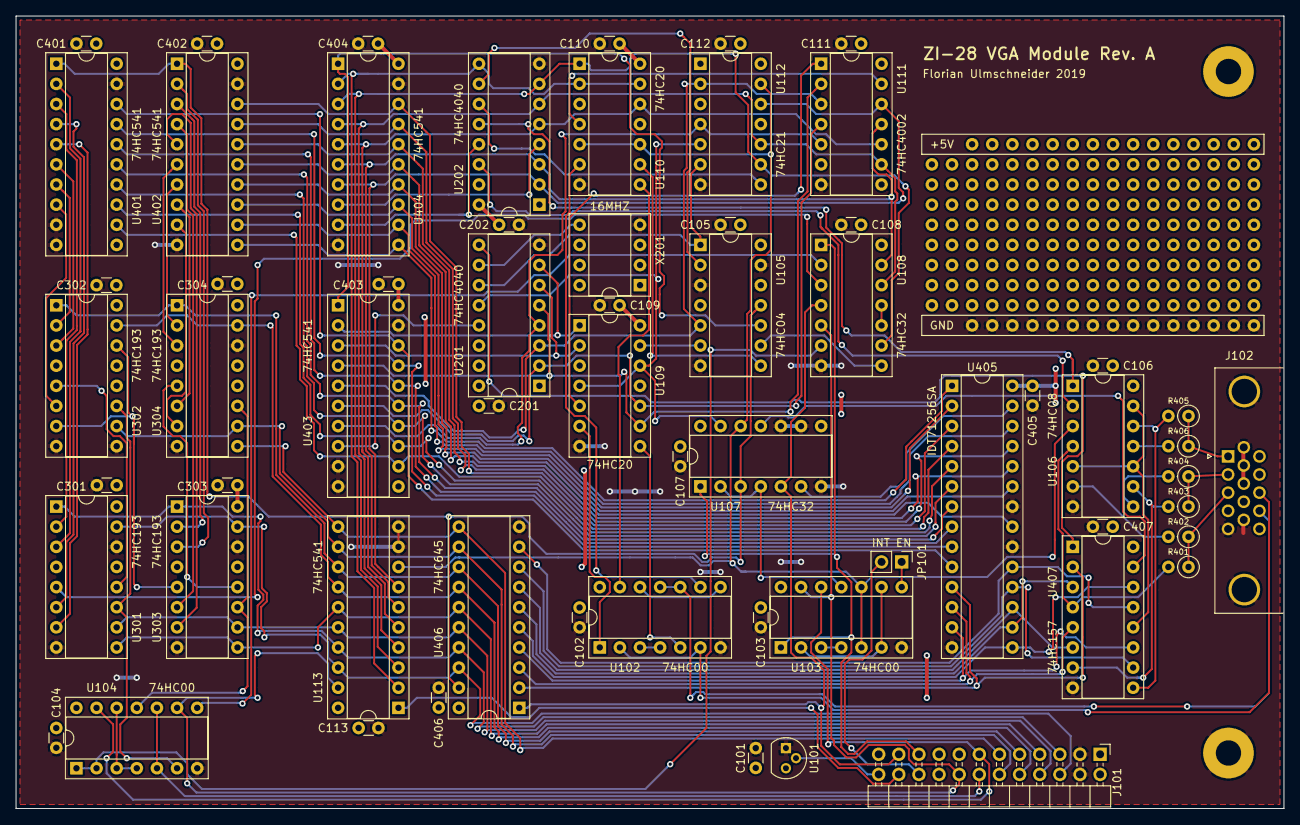
[picture p14: board vga.kicad_pcb from above]

Board: 2 copper layers, 160.0 x 100.0 mm, 64 parts (0 on the bottom side), 121 nets.
