fulmsch/ZI28/system/bank0/src/main.asm

#target rom

#data RAM,0x4000,0x4000

#code ROM,0x0000,0x4000

#define RST_coldStart 0x0000
#define RST_putc      0x0008
#define RST_getc      0x0010
#define RST_warmStart 0x0018

; Jump Table -------------------------------------------------
	jp      _coldStart   ;RST 0x00
	DEFB    0x00
	jp      0x00         ;CALL 0x04
	DEFB    0x00
	jp      _putc        ;RST 0x08
	DEFB    0x00
	jp      0x00         ;CALL 0x0C
	DEFB    0x00
	jp      _getc        ;RST 0x10
	DEFB    0x00
	jp      0x00         ;CALL 0x14
	DEFB    0x00
	jp      _warmStart   ;RST 0x18
	DEFB    0x00
	jp      0x00         ;CALL 0x1C
	DEFB    0x00
	jp      0x00         ;RST 0x20
	DEFB    0x00
	jp      0x00         ;CALL 0x24
	DEFB    0x00
	jp      0x00         ;RST 0x28
	DEFB    0x00
	jp      0x00         ;CALL 0x2C
	DEFB    0x00
	jp      0x00         ;RST 0x30
	DEFB    0x00
	jp      0x00         ;CALL 0x34
	DEFB    0x00
	jp      0x00         ;RST 0x38

#include "bootmenu.asm"
