fulmsch/ZI28/include/asm/errno.h

#define EPERM         1 ; Operation not permitted.
#define ENOENT        2 ; No such file or directory.
#define EINTR         3 ; Interrupted system call.
#define EIO           4 ; Input/output error.
#define ENXIO         5 ; No such device or address.
#define EBADF         6 ; Bad file descriptor.
#define ENOMEM        7 ; Cannot allocate memory.
#define EACCES        8 ; Permission denied.
#define EFAULT        9 ; Bad address.
#define ENOTBLK      10 ; Block device required.
#define EBUSY        11 ; Device or resource busy.
#define EEXIST       12 ; File exists.
#define ENODEV       13 ; No such device.
#define ENOTDIR      14 ; Not a directory.
#define EISDIR       15 ; Is a directory.
#define EINVAL       16 ; Invalid argument.
#define EMFILE       17 ; Too many open files.
#define ENFILE       18 ; Too many open files in system.
#define ENOTTY       19 ; Inappropriate ioctl for device.
#define EFBIG        20 ; File too large.
#define ENOSPC       21 ; No space left on device.
#define ESPIPE       22 ; Illegal seek.
#define EROFS        23 ; Read-only file system.
#define EDOM         24 ; Numerical argument out of domain.
#define ERANGE       25 ; Numerical result out of range.
#define EAGAIN       26 ; Resource temporarily unavailable.
#define EWOULDBLOCK  27 ; Operation would block.
#define EINPROGRESS  28 ; Operation now in progress.
#define EALREADY     29 ; Operation already in progress.
#define ENAMETOOLONG 30 ; File name too long.
#define ENOTEMPTY    31 ; Directory not empty.
#define EFTYPE       32 ; Inappropriate file type or format.
#define ENOSYS       33 ; Function not implemented.
#define ENOTSUP      34 ; Not supported.
#define ENOMSG       35 ; No message of desired type.
#define EOVERFLOW    36 ; Value too large for defined data type.
#define ETIME        37 ; Timer expired.
#define ECANCELED    38 ; Operation canceled.
#define EBADFD       39 ; File descriptor in bad state.
#define EPROCLIM     40 ; Too many processes.
#define E2BIG        41 ; Argument list too long.
