fulmsch/ZI28/(commit log)

2016-10-12 Fixed Makefiles
    [bcos.obj]
2016-10-12 Fixed FAT address calculation
    [bcos.obj]
2016-10-13 Added .gitignore
    [bcos.obj, bios.obj, cli.obj, echo.obj, mbr.obj, romutil.obj]
2016-10-15 Added framework for file access
2016-10-19 Both stages of the bootloader are functional
2016-12-10 Fixed Makefiles and nullterminators
    [monitor.asm]
2016-12-29 Switched emulator from c to c++
2016-12-29 Added framework for modules
2017-01-29 Began work on device filesystem
2017-01-31 Small fixes to previous commit
    [monitor.asm]
2017-01-31 Started mounting functionality
2017-01-31 Added functionality to open and read from devices
2017-02-02 Added file write, changed printStr to write to file
2017-02-08 Fixed calls to printStr
    [monitor.asm]
2017-02-17 SD-Card driver outline
2017-03-28 SDC-Driver basic structure
2017-04-01 SD block driver
2017-04-04 Sector offset in SD-driver
2017-04-22 Routine for following a cluster chain
2017-05-14 Updated mount command
2017-06-16 Automatically mount the main drive
2017-07-24 Ft240 now correctly returns the last char if no new one is available
    [emulator.c]
2017-08-03 Made printf work
2017-08-12 Print working directory in prompt
2017-08-14 Fix terminal carriage return
    [emulator.c]
2017-08-14 Move carriage return handling to device driver
2017-08-27 Fix SD driver for real hardware
2017-08-31 Reduce code duplication in block driver
2017-10-02 Fix console (terminal mode, potential buffer overflow)
    [main.c]
2017-10-03 Add rom file error handling
    [emulator.c, emulator.h, main.c]
2017-12-27 Optimise board generation.
2018-01-04 Move most variables to the correct location in ram.
    [main.asm, monitor.asm]
2018-02-15 Add prototype of execv.
2018-11-30 Fix multiple breakpoints at same address.
    [emulator.c, luainterface.c]
2018-11-30 Add functions for adding trace- and watchpoints.
2018-12-01 Add printInstruction.
2019-06-14 Add VGA module PCB.
    [Coord-Registers.sch, Pixel-Counters.sch, VRAM.sch, vga.kicad_pcb, vga.sch]
2019-06-15 Revert to single process with kernel shell.
    [interpreter.c, main.asm, main.c, monitor.asm, os.h]
2019-06-17 Kernel: Init function for device drivers.
2019-07-11 OS: Add decimal printing routines.
2019-07-11 OS: Start work on VGA text driver.
2019-11-23 Temporary fix to prevent rom writing.
    [emulator.c]
2019-12-02 OS: VT100 emulator for video card
    The VT100 driver can now display monochrome text from a buffer. Writing
    to the buffer works as well, but only to one position.
2019-12-03 OS: Implement backspace and newline in VT100 driver
    Text can now be displayed on the screen, but it is painfully slow as the
    entire screen is redrawn on each write.
2019-12-12 Design new VGA module
    Based on an ICE40 FPGA
    [fpga.sch, interface.sch, output.sch, vga-v2.kicad_pcb, vga-v2.sch]
2019-12-12 Use existing button
    [fpga.sch, vga-v2.kicad_pcb]
2019-12-12 VGA Module V2 Production Files
    Various changes, including: Smaller VGA connector, fix soldermask
    [output.sch, vga-v2.kicad_pcb]
